slydif/cncBoard-for-fluidnc/README.md

KiCad PCB for fluidnc CNC router.
- Opto-coupled inputs with hysterese (schmitt triggers)
- 16 extra outputs with i2s driven shiftregisters.
- 2 relais can be used.
- 5 axes can be used.
- Buck-converter can be attached
- SD-card support.
- Tested and working.
