slydif/cncBoard-for-fluidnc/cncBord4sdo/projectData/6-Pack_CNC_Controller-main/images/6_pack_expansion.jpg

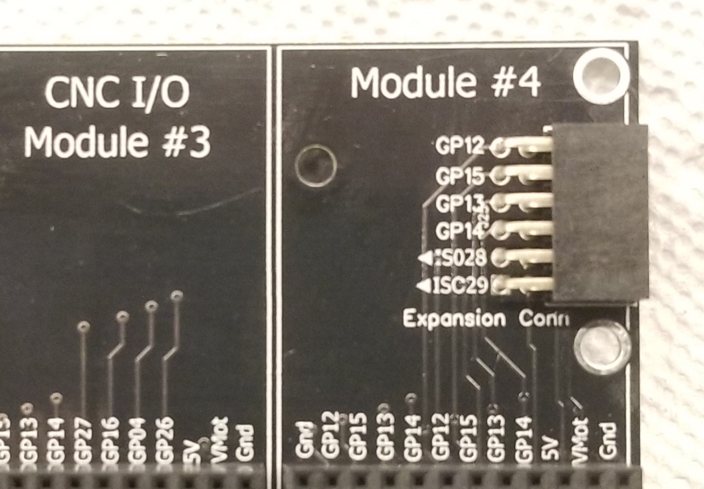
cncBord4sdo/projectData/6-Pack_CNC_Controller-main/images/6_pack_expansion.jpg
