slydif/cncBoard-for-fluidnc/cncBord4sdo/projectData/6-Pack_CNC_Controller-main/images/20200711_132253.jpg

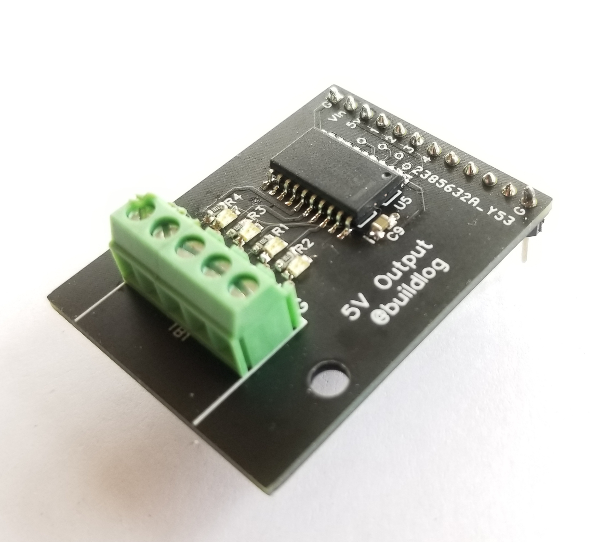
cncBord4sdo/projectData/6-Pack_CNC_Controller-main/images/20200711_132253.jpg
