slydif/cncBoard-for-fluidnc/cncBord4sdo/projectData/6-Pack_CNC_Controller-main/images/expansion_port_pinout.png

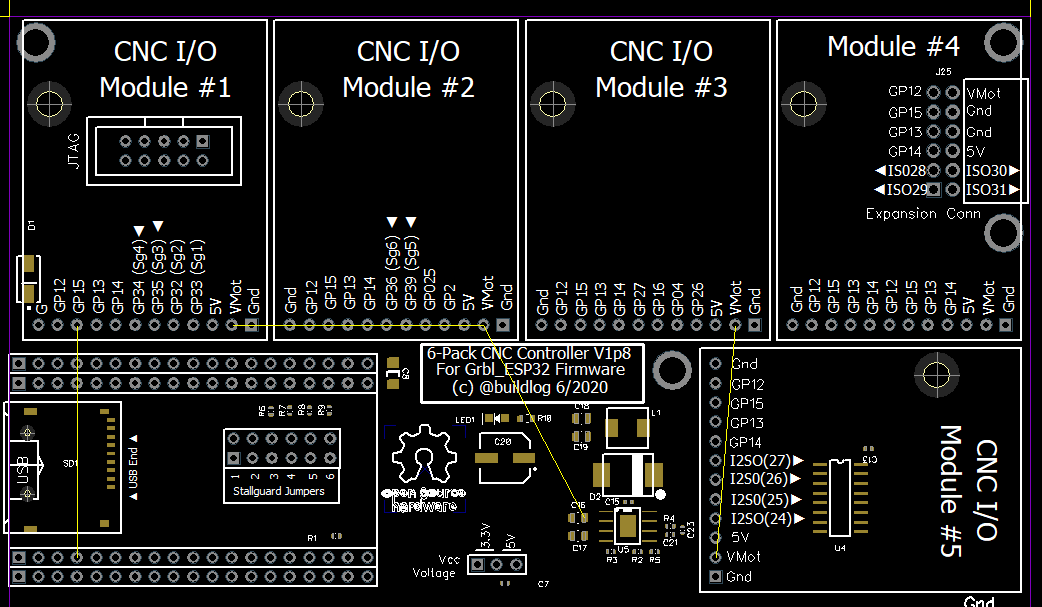
cncBord4sdo/projectData/6-Pack_CNC_Controller-main/images/expansion_port_pinout.png
