slydif/cncBoard-for-fluidnc/cncBord4sdo/projectData/6-Pack_CNC_Controller-main/images/iot_relay.png

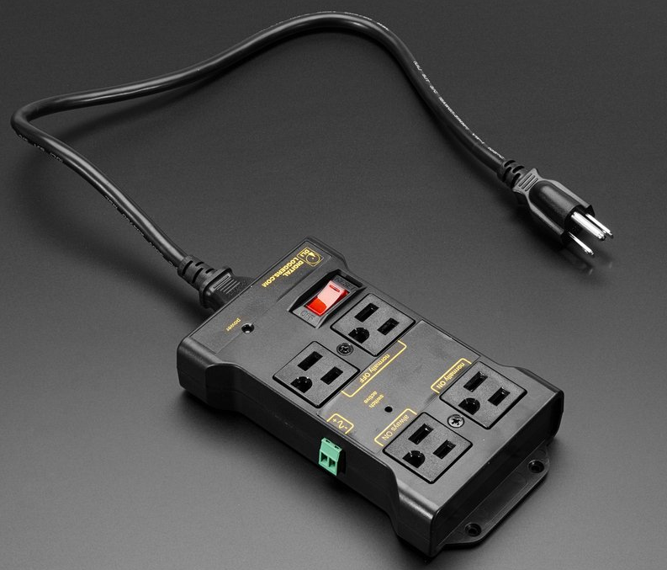
cncBord4sdo/projectData/6-Pack_CNC_Controller-main/images/iot_relay.png
