slydif/cncBoard-for-fluidnc/cncBord4sdo/projectData/6-Pack_CNC_Controller-main/images/switch_types.png

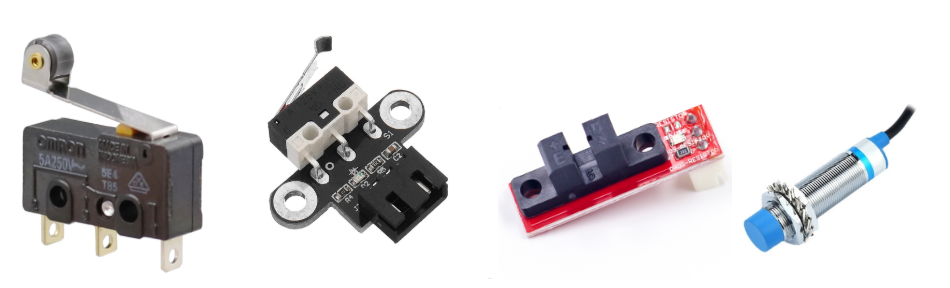
cncBord4sdo/projectData/6-Pack_CNC_Controller-main/images/switch_types.png
