slydif/cncBoard-for-fluidnc/cncBord4sdo/projectData/HTB1w9n5KVXXXXc5XVXX760XFXXXu.png

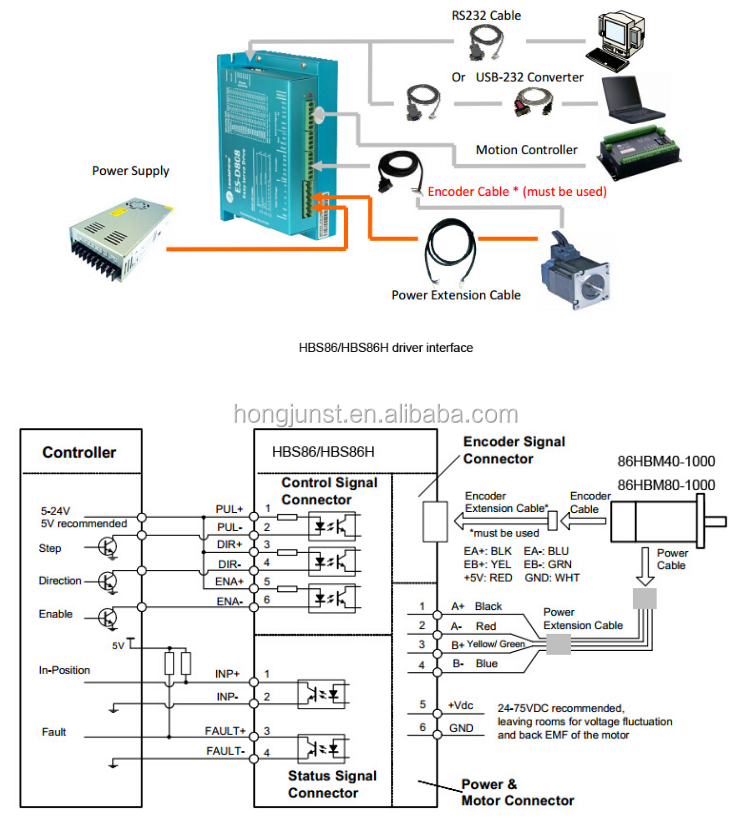
cncBord4sdo/projectData/HTB1w9n5KVXXXXc5XVXX760XFXXXu.png
