slydif/cncBoard-for-fluidnc/cncBord4sdo/projectData/sdcard board.jpg

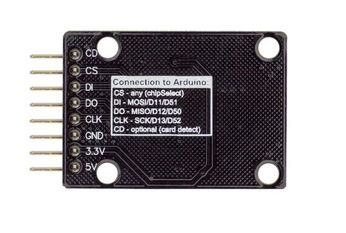
cncBord4sdo/projectData/sdcard board.jpg
