slydif/cncBoard-for-fluidnc/cncBord4sdo/projectData/sdCard pinout.jpg

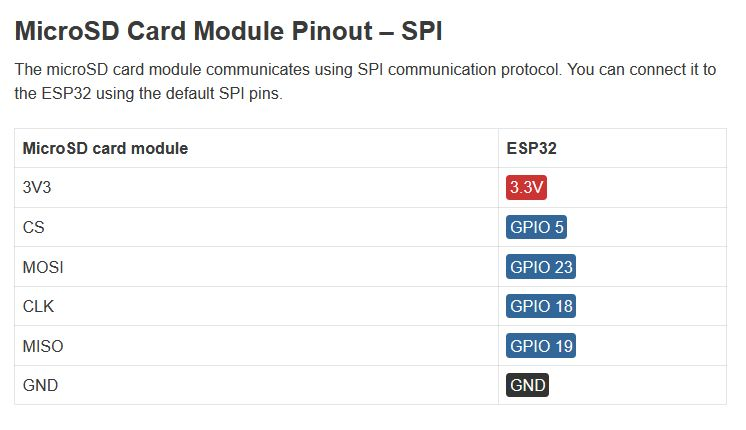
cncBord4sdo/projectData/sdCard pinout.jpg
