slydif/cncBoard-for-fluidnc/cncBord4sdo/projectData/6-Pack_CNC_Controller-main/versions/V1p1/gerbers/BOM 6_Pack_V1p1.xlsx

RefDes | Quantity | Qty SMT | Qty TH | Name | Value | Manufacturer | Mfg P/N | Source
C1, C2 | 2 | 2 |  | Capacitor 1206 | 10uF | Taiyo Yuden | GMK316BJ106KL-T | https://lcsc.com/product-detail/Multilayer-Ceramic-Capacitors-MLCC-SMD-SMT_Taiyo-Yuden-GMK316BJ106KL-T_C92797.html
C3, C6, C7, C13, C14, C23, C24, C25, C26, C27, C28 | 11 | 11 |  | Capacitor 0805 | 100nF | Kemet | C0805C104K5RACAUTO | https://lcsc.com/product-detail/Multilayer-Ceramic-Capacitors-MLCC-SMD-SMT_KEMET_C0805C104K5RACAUTO_100nF-104-10-50V-Car-level_C129641.html
C4 | 1 | 1 |  | Capacitor 0805 | 150pF | CCTC | TCC0805X7R151K500BT | https://lcsc.com/product-detail/Multilayer-Ceramic-Capacitors-MLCC-SMD-SMT_CCTC-TCC0805X7R151K500BT_C282743.html
C5, C9 | 2 | 2 |  | Capacitor 1206 | 22uF 6.3V | Taiyo Yuden | JMK316BJ226KL-T | https://lcsc.com/product-detail/Multilayer-Ceramic-Capacitors-MLCC-SMD-SMT_TAIYO-YUDEN_JMK316BJ226KL-T_22uF-226-10-6-3V_C92791.html
C8 | 1 | 1 |  | Capacitor, Electrolytic | 100u 16V | Panasonic | EEEHAC101WAP | https://lcsc.com/product-detail/Aluminum-Electrolytic-Capacitors-SMD_PANASONIC-EEEHAC101WAP_C336467.html
C17, C18, C19, C20, C21, C22 | 6 | 6 |  | Capacitor, Electrolytic | 330uF 50V | Lelon | VZT331M1HTR-1010 | https://lcsc.com/product-detail/Others_Lelon-VZT331M1H1010-TRO_C249985.html
D1, D2 | 2 | 2 |  | Diode, Schottkey 3A DO-214AC | 3A | (MDD) Jiangsu Yutai Elec | C64982 | https://lcsc.com/product-detail/Schottky-Barrier-Diodes-SBD_Jiangsu-Yutai-Elec-B340A_C64982.html
J1, J3, J6,J9 | 4 |  | 4 | 1x19 Female Header 0.1 |  | AliExpress |  | https://www.aliexpress.com/item/100Pcs-Per-Lot-2-54mm-Pitch-1x19-Pin-19-Pin-Female-Single-Row-Straight-Header-Strip/32760221364.html
J4, J5, J8, JP1, JP2, JP3, JP4 | 7 |  | 7 | Header, Male 1x3 0.1 | 1x3 | Boom Precision Elec | C49257 | https://lcsc.com/product-detail/Pin-Header-Female-Header_BOOMELE-Boom-Precision-Elec-C49257_C49257.html
J12 | 1 |  | 1 | Header, Male 2x6 | 2x6 | MINTRON | MTP125-1206S1 | https://lcsc.com/product-detail/Pin-Header-Female-Header_MINTRON-MTP125-1206S1_C358695.html
J14, J15, J16, J17, J18, J19, J26, J27, J28, J29, J30, J31 | 12 |  | 12 | Header, Female 1x8 | 1x8 | BOOMELE(Boom Precision Elec) | C27438 | https://lcsc.com/product-detail/Female-Header_2-54mm-1-8P-Straight-Female-header_C27438.html
J20, J21, J22, J23, J24, J25 | 6 |  | 6 | Header, Female 1x2 | 1x2 | BOOMELE(Boom Precision Elec) | C49661 | https://lcsc.com/product-detail/Pin-Header-Female-Header_BOOMELE-Boom-Precision-Elec-C49661_C49661.html
J33 | 0 |  |  | Do not place
L1 | 1 | 1 |  | Inductor | 4.7uH | Chilisin Elec | MHCI06030-4R7M-R8 | https://lcsc.com/product-detail/Power-Inductors_Chilisin-Elec-MHCI06030-4R7M-R8_C108295.html
LED1 | 1 | 1 |  | LED Clear Green 0805 |  | Foshan NationStar Optoelectronics | NCD0805G1 | https://lcsc.com/product-detail/Light-Emitting-Diodes-LED_Emerald-SMDLED-Iv-220-270mcd-atIF-5mA_C84260.html
MOD1, MOD2, MOD3, MOD4, MOD5 | 5 |  | 5 | Header, Feamle 1x12 | 1x12 | HOAUC | 2685Y-112CNG1SNA01 | https://lcsc.com/product-detail/Pin-Header-Female-Header_HOAUC-2685Y-112CNG1SNA01_C350303.html
R1, R2 | 2 | 2 |  | RES_0805 | 100k | YAGEO | AC0805FR-07100KL | https://lcsc.com/product-detail/Chip-Resistor-Surface-Mount_100KR-1003-1_C144587.html
R3 | 1 | 1 |  | RES_0805 | 40.2k | YAGEO | AC0805FR-0740K2L | https://lcsc.com/product-detail/Others_YAGEO-AC0805FR-0740K2L_C228820.html
R4 | 1 | 1 |  | RES_0805 | 210k | YAGEO | AC0805FR-07210KL | https://lcsc.com/product-detail/Others_YAGEO-AC0805FR-07210KL_C228629.html
R5, R6, R7, R8 | 4 | 4 |  | RES_0805 | 10k | YAGEO | AC0805FR-0710KL | https://lcsc.com/product-detail/Chip-Resistor-Surface-Mount_10KR-1002-1_C140868.html
R10 | 1 | 1 |  | RES_0805 | 300R | YAGEO | RC0805FR-07300RL | https://lcsc.com/product-detail/Chip-Resistor-Surface-Mount_300R-300R-1_C114529.html
SD1 | 1 | 1 |  | TF-01A |  | Korean Hroparts Elec TF-01A | TF-01A | https://lcsc.com/product-detail/Connector-Card-Sockets_Korean-Hroparts-Elec-TF-01A_C91145.html
TB1 | 1 |  | 1 | 2 Pos Terminal Block |  | Ningbo Xinlaiya Elec. | XY2500R-B-5.00-2P | https://lcsc.com/product-detail/Pluggable-System-Terminal-Block_Ningbo-Xinlaiya-Elec-XY2500R-B-5-00-2P_C505815.html
TB2, TB3, TB4, TB5, TB6, TB7 | 0 |  |  | 4 Pos Terminal Block |  | Phoenix Contact | 1945119 | https://www.mouser.com/ProductDetail/Phoenix-Contact/1945119?qs=BYlwlsDsB%2FoxVFDUDE1oIQ%3D%3D
U1 | 1 | 1 |  | Power Supply, Buck 3A | 3A | Monolithic Power Systems | MP1584EN-LF-Z | https://lcsc.com/product-detail/DC-DC-Converters_MPS_MP1584EN-LF-Z_MP1584EN-LF-Z_C15051.html
U2, U3, U4, U5 | 4 | 4 |  | 74AHCT595 | 74AHCT595 | Nexperia | 74AHCT595D,118 | https://www.mouser.com/ProductDetail/Nexperia/74AHCT595D118?qs=P62ublwmbi%2FjQEpjzH34Ig%3D%3D
Totals | 65 | 29 | 36
