slydif/cncBoard-for-fluidnc/cncBord4sdo/projectData/6-Pack_CNC_Controller-main/versions/V1p8/gerbers/6_Park_V1p8_BOM.xlsx

RefDes | Value | Name | Quantity | SMT | TH | Manufacturer | MFG P/N | Source
C1, C2, C3, C4, C5, C6, C7, C9, C11, C13, C15 | 100nF | NP_100nF_50V_0402 | 11 | 11 |  | Samsung Electro-Mechanics | CL05B104KB54PNC | https://lcsc.com/product-detail/Others_Samsung-Electro-Mechanics_CL05B104KB54PNC_Samsung-Electro-Mechanics-CL05B104KB54PNC_C307331.html
C8 | Do Not Place | NP_DNP_1206 |  |  |  | DNP | DN
C10, C12, C14, C22, C24, C25 | 330uF | POL_330uF_50V_10x10 | 6 | 6 |  | KS | UT1H331M1010VG | https://lcsc.com/product-detail/Aluminum-Electrolytic-Capacitors-SMD_KS-UT1H331M1010VG_C963258.html
C16, C17 | 2.2uF 50V | NP_2.2uF_50V_0805 | 2 | 2 |  | Guangdong Fenghua Advanced Tech | 0805F225M500NT | https://lcsc.com/product-detail/Multilayer-Ceramic-Capacitors-MLCC-SMD-SMT_FH-Guangdong-Fenghua-Advanced-Tech-0805F225M500NT_C49217.html
C18, C19 | 47uF 6.3V | NP_47uF_6.3V_0805 | 2 | 2 |  | Samsung Electro-Mechanics | CL21A476MQYNNNE | https://lcsc.com/product-detail/Multilayer-Ceramic-Capacitors-MLCC-SMD-SMT_SAMSUNG_CL21A476MQYNNNE_47uF-476-20-6-3V_C16780.html
C20 | 100uF 16V | POL_100uF_16V_6.3x5.4 | 1 | 1 |  | ROQANG | RT1C101M0605 | https://lcsc.com/product-detail/Aluminum-Electrolytic-Capacitors-SMD_ROQANG-RT1C101M0605_C267461.html
C21 | 39pF 50V | NP_39pF_50V_0402 | 1 | 1 |  | Yageo | CC0402JRNPO9BN390 | https://lcsc.com/product-detail/Multilayer-Ceramic-Capacitors-MLCC-SMD-SMT_39pF-390-5-50V_C106223.html/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
C23 | 6.8nF 50V | NP_6.8nF_50V_0402 | 1 | 1 |  | Guangdong Fenghua Advanced Tech | 0402B682K500NT | https://lcsc.com/product-detail/Multilayer-Ceramic-Capacitors-MLCC-SMD-SMT_6-8nF-682-10-50V_C1542.html
D1 | 40V 3A | Schottkey_40V_3A_DO-214AC | 1 | 1 |  | MDD（Microdiode Electronics） | B340A | https://lcsc.com/product-detail/Schottky-Barrier-Diodes-SBD_Jiangsu-Yutai-Elec-B340A_C64982.html
D2 | B560C | B560C | 1 | 1 |  | Diodes Incorporated | B560C-13-F | https://lcsc.com/product-detail/Schottky-Barrier-Diodes-SBD_Diodes-Incorporated-B560C-13-F_C85100.html
J1, J8, J12, J15, J19, J26 | 2 Pos | HDR Socket 1x2 0.1 | 6 |  | 6 | BOOMELE(Boom Precision Elec) | C49661 | https://lcsc.com/product-detail/Pin-Header-Female-Header_BOOMELE-Boom-Precision-Elec-C49661_C49661.html
J2, J3, J9, J10, J13, J14, J16, J17, J20, J21, J27, J28 | 8S | HDR Socket 1x8 0.1 | 12 |  | 12 | BOOMELE(Boom Precision Elec) | C27438 | https://lcsc.com/product-detail/Female-Header_2-54mm-1-8P-Straight-Female-header_C27438.html
J4, J5, J6, J7 | 19S | HDR Socket 1x19 0.1 | 4 |  | 4 | BOOMELE(Boom Precision Elec) | C319202 | https://lcsc.com/product-detail/Lack-of-specifications_BOOMELE-Boom-Precision-Elec-C319202_C319202.html
J11 | Do Not Place | DC3-10P
J18 | 6S | HDR Pin 2x6 0.1 | 1 |  | 1 | MINTRON | MTP125-1206S1 | https://lcsc.com/product-detail/Pin-Header-Female-Header_MINTRON-MTP125-1206S1_C358695.html
J22, J23, J24 | 3P | HDR Pin 1x3 0.1 | 3 |  | 3 | BOOMELE(Boom Precision Elec) | C49257 | https://lcsc.com/product-detail/Pin-Header-Female-Header_BOOMELE-Boom-Precision-Elec-C49257_C49257.html
J25 | Do Not Place | Header_2x6S_RA |  |  | 1
JP1, JP2, JP3, JP4 | 3P | Jumper_3p | 4 |  | 4 | BOOMELE(Boom Precision Elec) | C49257 | https://lcsc.com/product-detail/Pin-Header-Female-Header_BOOMELE-Boom-Precision-Elec-C49257_C49257.html
L1 | 10uH | 10uH_SMD_5.2x5.4 | 1 | 1 |  | Sunlord | MWSA0503S-100MT | https://lcsc.com/product-detail/Power-Inductors_Sunlord-MWSA0503S-100MT_C408412.html
LED1 | GRN | LED_GRN_0805 (Foshan) | 1 | 1 |  | Foshan NationStar Optoelectronics | NCD0805G1 | https://lcsc.com/product-detail/Light-Emitting-Diodes-LED_Foshan-NationStar-Optoelectronics-NCD0805G1_C84260.html
MH1, MH2, MH3, MH4, MH5, MH6 | Do Not Place | Mounting_hole_M3.7
MOD1, MOD2, MOD3, MOD4, MOD5 | 1x12 Socket | CNC_Module_Socket | 5 |  | 5 | CJT(Changjiang Connectors) | A2541HWV-12P | https://lcsc.com/product-detail/Pin-Header-Female-Header_CJT-Changjiang-Connectors-A2541HWV-12P_C225509.html
R1, R6, R7, R8, R9 | 10k | 10k_0402 | 5 | 5 |  | YAGEO | RC0402FR-0710KL | https://lcsc.com/product-detail/Chip-Resistor-Surface-Mount_YAGEO-RC0402FR-0710KL_C60490.html
R2 | 270k | 270k_0402 | 1 | 1 |  | Uniroyal Elec | 0402WGF2703TCE | https://lcsc.com/product-detail/Chip-Resistor-Surface-Mount_Uniroyal-Elec-0402WGF2703TCE_C25770.html/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
R3 | 100k | 100k_0402 | 1 | 1 |  | Uniroyal Elec | 0402WGF1003TCE | https://lcsc.com/product-detail/Chip-Resistor-Surface-Mount_Uniroyal-Elec-0402WGF1003TCE_C25741.html/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
R4 | 13k | 13k_0402 | 1 | 1 |  | Uniroyal Elec | 0402WGF1302TCE | https://lcsc.com/product-detail/Chip-Resistor-Surface-Mount_UNI-ROYAL-Uniroyal-Elec-0402WGF1302TCE_C25754.html
R5 | 51k | 51k_0402 | 1 | 1 |  | Uniroyal Elec | 0402WGF5102TCE | https://lcsc.com/product-detail/Chip-Resistor-Surface-Mount_Uniroyal-Elec-0402WGF5102TCE_C25794.html/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
R10 | 3.0k | 3.0k_0603 | 1 | 1 |  | YAGEO | RC0603FR-073KL | https://lcsc.com/product-detail/Chip-Resistor-Surface-Mount_3KR-3001-1_C126358.html
SD1 | Micro SD | TF-01A | 1 | 1 |  | Korean Hroparts Elec | TF-01A | https://lcsc.com/product-detail/Card-Sockets-Connectors_Korean-Hroparts-Elec-TF-01A_C91145.html
TB1, TB2, TB3, TB5, TB6, TB7 | 4 Pos | TB_3p5mm_4POS_KF2EDGR | 6 |  | 6 | Cixi Kefa Elec | KF2EDGR-3.5-4P | https://lcsc.com/product-detail/Pluggable-System-Terminal-Block_Cixi-Kefa-Elec-KF2EDGR-3-5-4P_C441173.html
TB4 | 2 Pos | TB_5mm_2POS Socket | 1 |  | 1 | Ningbo Xinlaiya Elec. | XY2500R-B-5.00-2P | https://lcsc.com/product-detail/Pluggable-System-Terminal-Block_Ningbo-Xinlaiya-Elec-XY2500R-B-5-00-2P_C505815.html
U1, U2, U3, U4 | 74AHCT595 | 74AHCT595 | 4 | 4 |  | Texas Instruments | SN74AHCT595DR | https://lcsc.com/product-detail/74-Series_Texas-Instruments_SN74AHCT595DR_Texas-Instruments-Texas-Instruments-SN74AHCT595DR_C133793.html
U5 | TPS54360 | TPS54360DDAR | 1 | 1 |  | Texas Instruments | TPS54360DDAR | https://lcsc.com/product-detail/DC-DC-Converters_Texas-Instruments-Texas-Instruments-TPS54360DDAR_C44377.html
 |  | Total parts | 86 | 44 | 43
 |  | Unique count | 29 | 20 | 10
