slydif/cncBoard-for-fluidnc/cncBord4sdo/projectData/6-Pack_CNC_Controller-main/CNC_IO_Modules/0_10V_Spindle/V1p1/Gerbers/BOM CNC Module 0_10V.xlsx

RefDes | Quantity | Qty SMT | Qty TH | Value | Name | Pattern | Manufacturer | MFG P/N | Source | Alt Source
C1, C2 | 1 | 1 |  | 100nF | CAP_0805 | CAP_0805 | Kemet | C0805C104K5RACAUTO | https://lcsc.com/product-detail/Multilayer-Ceramic-Capacitors-MLCC-SMD-SMT_KEMET_C0805C104K5RACAUTO_100nF-104-10-50V-Car-level_C129641.html
LED1, LED2, LED3, LED4 | 4 | 4 |  | Green | LED Green Clear | 805 | Lite-On | LTST-C170KGKT | https://lcsc.com/product-detail/Light-Emitting-Diodes-LED_Lite-On-LTST-C170KGKT_C98221.html
MOD1 | 1 |  | 0 | Do not place
OPT1, OPT2 | 2 | 2 |  | Opto | Opto | SMD4 | Everlight Elec | EL817S1(D)(TU)-F | https://lcsc.com/product-detail/Optocouplers_Everlight-Elec-EL817S1-D-TU-F_C108319.html
R1, R2, R3, R4, R5 | 5 | 5 |  | 300R | Resistor 300R 1% |  | YAGEO | AC0805FR-07300RL | https://lcsc.com/product-detail/_AC0805FR-07300RL_C144566.html
R6, R9, R10 | 4 | 4 |  | 10k | Resistor 10k 1% | RES_0805 | YAGEO | AC0805FR-0710KL | https://lcsc.com/product-detail/Chip-Resistor-Surface-Mount_10KR-1002-1_C140868.html
R7 | 1 | 1 |  | 20k | Pot 20K SMT | Pot | HDK(Hokuriku Elec Industry) | VG039NCHXTB203 | https://lcsc.com/product-detail/Variable-Resistors_HDK-Hokuriku-Elec-Industry-VG039NCHXTB203_C128550.html
R8 | 1 | 1 |  | 4.99K | Resistor 4.99K 1% 0805 | 805 | YAGEO | AC0805FR-074K99L | https://lcsc.com/product-detail/Others_YAGEO-AC0805FR-074K99L_C228871.html
TB1 | 1 |  | 0 | Do Not Place
U1 | 1 | 1 |  | LM358P | LM358 | SOIC-8 | STMicroelectronics | LM358ADT | https://lcsc.com/product-detail/General-Purpose-Amplifiers_STMicroelectronics-LM358ADT_C92457.html
Total |  | 19
