slydif/cncBoard-for-fluidnc/cncBord4sdo/projectData/6-Pack_CNC_Controller-main/CNC_IO_Modules/4x_Opto_Input/V1p1/fab/BOM_Input_Module_V1p1.xlsx

RefDes | Quantity | Qty SMT | Qty TH | Value | Name | Pattern | Manufacturer | Mfg P/N | Source
C1, C2 | 2 | 2 |  | 1uF | Capacitor 0805 1uF 50V 20% | CAP_0805 | CCTC | TCC0805X7R105K500DTB | https://lcsc.com/product-detail/Multilayer-Ceramic-Capacitors-MLCC-SMD-SMT_CCTC-TCC0805X7R105K500DTB_C282736.html
C3 | 1 | 1 |  | 2.2uF | Capacitor 0805 | CAP_0805 | Samsung Electro-Mechanics | CL21B225KOFNNNE | https://lcsc.com/product-detail/Multilayer-Ceramic-Capacitors-MLCC-SMD-SMT_SAMSUNG_CL21B225KOFNNNE_2-2uF-225-10-16V_C28234.html
C4, C5, C6, C7, C8 | 4 | 4 |  | 100nF | Capacitor 0603 | CAP_0603 | Walsin Tech Corp | 0603F104Z250 | https://lcsc.com/product-detail/Multilayer-Ceramic-Capacitors-MLCC-SMD-SMT_Walsin-Tech-Corp-0603F104Z250_C125841.html
MOD1 | 0 |  |  |  | Header, Male 1x12 0.1" | Do Not Place
OPT1 | 1 | 1 |  | TP521-4 | Optocoupler | TLP521-4SM | Isocom Components | TLP521-4GBSM | https://lcsc.com/product-detail/Optocouplers_Isocom-Components-TLP521-4GBSM_C191332.html
PS1 | 1 |  | 0 | 5V | Isloated P/S 5V/5V | Do Not Place
PS2 | 1 | 1 |  |  | LDO 5V | SOT89 | Diodes Incorporated | AP2204RA-3.3TRG1 | https://lcsc.com/product-detail/Low-Dropout-Regulators-LDO_Diodes-Incorporated-AP2204RA-3-3TRG1_C151625.html
R1, R2, R3, R4 | 4 | 4 |  | 300 | Resitor 0603 | RES_0603 | LIZ Elec | CR0603JA0301G | https://lcsc.com/product-detail/Chip-Resistor-Surface-Mount_LIZ-Elec-CR0603JA0301G_C101323.html
R5, R6, R7, R8 | 4 | 4 |  | 10k | Resitor 0603 | RES_0603 | YAGEO | RC0603FR-0710KL | https://lcsc.com/product-detail/Chip-Resistor-Surface-Mount_10KR-1002-1_C98220.html
R9, R10, R11, R12, R13 | 5 | 5 |  | 220 | Resitor 0603 | RES_0805 | YAGEO | RC0603FR-07220RL | https://lcsc.com/product-detail/Chip-Resistor-Surface-Mount_220R-220R-1_C107696.html
TB1, TB3 | 0 |  | 0 |  | Do not place | Do not place
TB2, TB4 | 0 |  | 0 |  | Do not place | Do not place
U2 | 1 | 1 |  |  | Schmitt Trigger SN74AC14D | TSSOP-14 | Texas Instruments | SN74HC14PWR | https://lcsc.com/product-detail/Gates-and-Inverters_Texas-Instruments_SN74HC14PWR_Texas-Instruments-Texas-Instruments-SN74HC14PWR_C6821.html
 |  | 23
