slydif/cncBoard-for-fluidnc/cncBord4sdo/projectData/6-Pack_CNC_Controller-main/CNC_IO_Modules/RS485/V1p0/fab/BOM CNC Module RS485 V1p1.xlsx

RefDes | Quantity | Qty SMT | Qty TH | Value | Name | Pattern | Manufacturer | MFG P/N | Source
C1 | 1 | 1 |  | 10uF | CAP_NP_1206 | CAP_1206 | Taiyo Yuden | GMK316BJ106KL-T | https://lcsc.com/product-detail/Multilayer-Ceramic-Capacitors-MLCC-SMD-SMT_Taiyo-Yuden-GMK316BJ106KL-T_C92797.html
C2 | 1 | 1 |  | 22uF |  | CAP_1206 | Taiyo Yuden | JMK316BJ226KL-T | https://lcsc.com/product-detail/Multilayer-Ceramic-Capacitors-MLCC-SMD-SMT_TAIYO-YUDEN_JMK316BJ226KL-T_22uF-226-10-6-3V_C92791.html
C3 | 1 | 1 |  | 100nF | CAP_0805 | CAP_0805 | Kemet | C0805C104K5RACAUTO | https://lcsc.com/product-detail/Multilayer-Ceramic-Capacitors-MLCC-SMD-SMT_KEMET_C0805C104K5RACAUTO_100nF-104-10-50V-Car-level_C129641.html
MOD1 | 1 |  | 0 |  | Do not place
R1, R2, R3 | 3 | 3 |  | 10k | RES_0805 | RES_0805 | YAGEO | AC0805FR-0710KL | https://lcsc.com/product-detail/Chip-Resistor-Surface-Mount_10KR-1002-1_C140868.html
R4, R6 | 2 | 2 |  | 20k | RES_0805 | RES_0805 | YAGEO | RC0805FR-0720KL | https://lcsc.com/product-detail/Chip-Resistor-Surface-Mount_20KR-2002-1_C114566.html
R5 | 1 | 1 |  | 120 | RES_0805 | RES_0805 | YAGEO | RC0805FR-07120RL | https://lcsc.com/product-detail/Chip-Resistor-Surface-Mount_120R-120R-1_C114245.html
TB1 | 1 |  | 0 |  | Do Not Place
U1 | 1 | 1 |  | 3.3V | AMS1117 | SOT223-4 | Advanced Monolithic Systems | AMS1117-3.3 | https://lcsc.com/product-detail/Low-Dropout-Regulators-LDO_AMS_AMS1117-3-3_AMS1117-3-3_C6186.html
U2 | 1 | 1 |  |  | MAX485CSA | SOIC-8/150mil | Maxim Integrated | MAX3485ESA+T | https://lcsc.com/product-detail/RS-485-RS-422-ICs_Maxim-Integrated_MAX3485ESA-T_Maxim-Integrated-MAX3485ESA-T_C18148.html
Total |  | 11
