slydif/cncBoard-for-fluidnc/cncBord4sdo/projectData/6-Pack_CNC_Controller-main/3D_Files/4x_support.stp

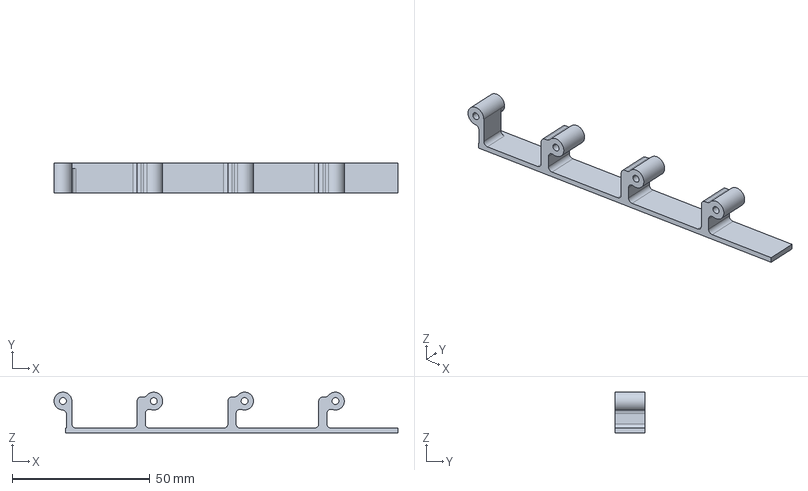
[picture p17: CAD file, 2023-04-05]
cncBord4sdo/projectData/6-Pack_CNC_Controller-main/3D_Files/4x_support.stp
125.1 x 11.0 x 14.8 mm
