slydif/cncBoard-for-fluidnc/cncBord4sdo/projectData/6-Pack_CNC_Controller-main/3D_Files/case/6_pack_case_bottom.stp

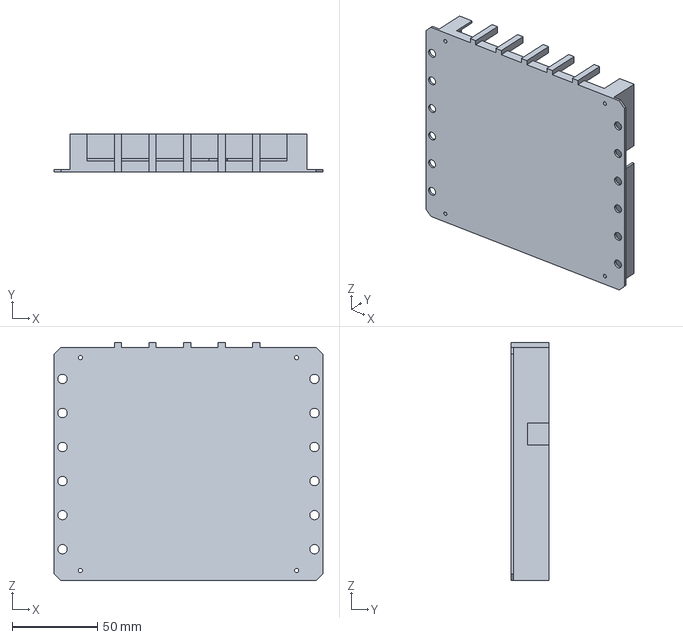
[picture p18: CAD file, 2023-04-05]
cncBord4sdo/projectData/6-Pack_CNC_Controller-main/3D_Files/case/6_pack_case_bottom.stp
158.0 x 22.2 x 140.0 mm
