slydif/cncBoard-for-fluidnc/cncBord4sdo/projectData/6-Pack_CNC_Controller-main/3D_Files/1x_supp.stp

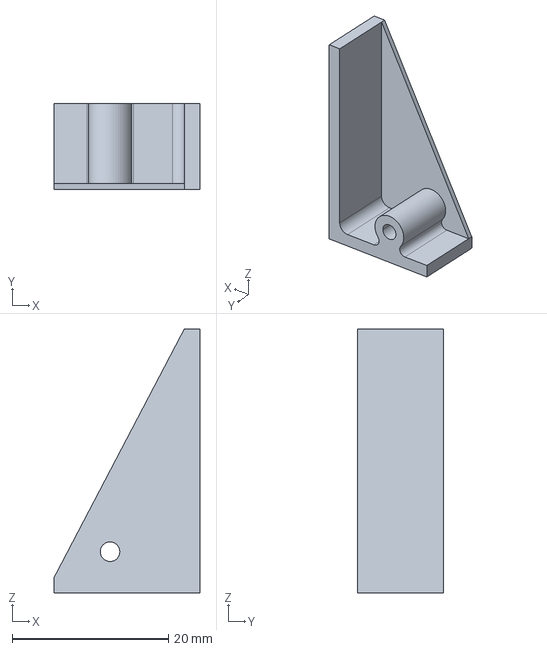
[picture p19: CAD file, 2023-04-05]
cncBord4sdo/projectData/6-Pack_CNC_Controller-main/3D_Files/1x_supp.stp
18.7 x 11.0 x 33.8 mm
