slydif/cncBoard-for-fluidnc/cncBord4sdo/projectData/6-Pack_CNC_Controller-main/3D_Files/case/6_pack_cover_top.stp

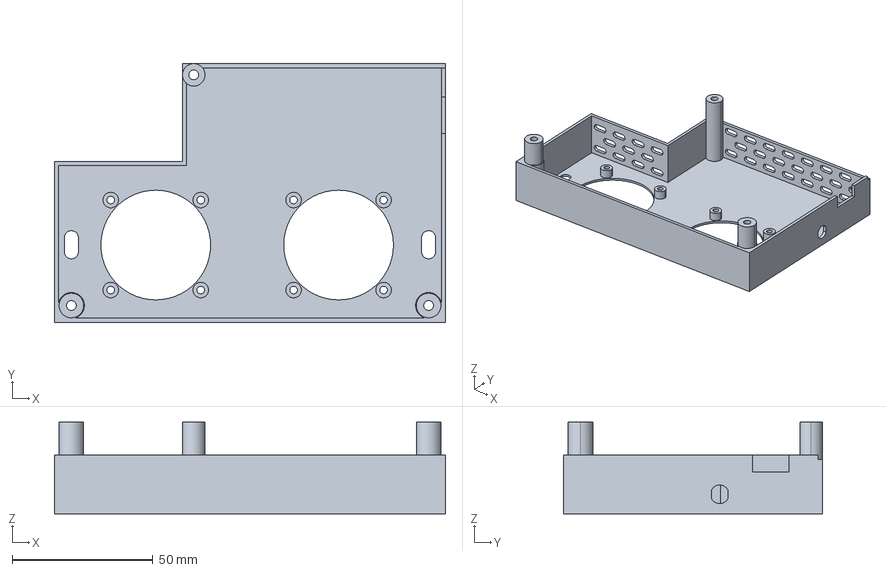
[picture p20: CAD file, 2023-04-05]
cncBord4sdo/projectData/6-Pack_CNC_Controller-main/3D_Files/case/6_pack_cover_top.stp
139.0 x 92.0 x 32.7 mm
