slydif/cncBoard-for-fluidnc/cncBord4sdo/projectData/6-Pack_CNC_Controller-main/3D_Files/case/dummy_module.stl

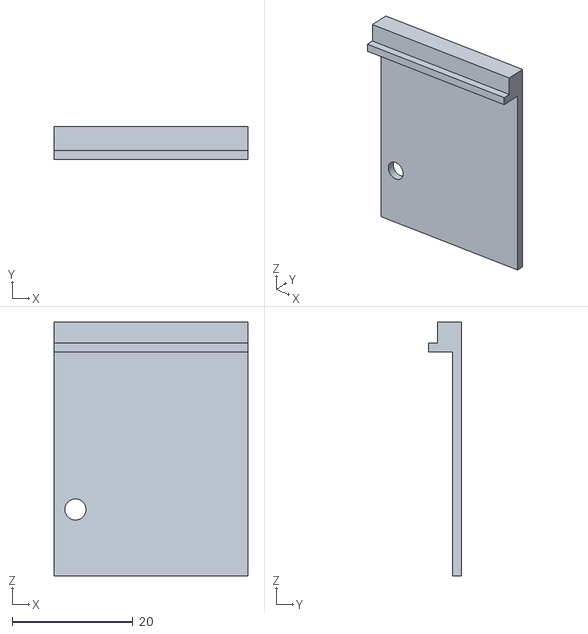
[picture p21: CAD file, 2023-04-05]
cncBord4sdo/projectData/6-Pack_CNC_Controller-main/3D_Files/case/dummy_module.stl
32.0 x 5.50 x 42.0
