slydif/cncBoard-for-fluidnc/(list of files, cad)

Other CAD files:
cncBord4sdo/projectData/6-Pack_CNC_Controller-main/3D_Files/1x_supp.stl
cncBord4sdo/projectData/6-Pack_CNC_Controller-main/3D_Files/4x_support.stl
cncBord4sdo/projectData/6-Pack_CNC_Controller-main/3D_Files/case/6_pack_case_bottom.stl
cncBord4sdo/projectData/6-Pack_CNC_Controller-main/3D_Files/case/6_pack_cover_top.stl
