slydif/cncBoard-for-fluidnc/cncBord4sdo/projectData/hbs86H wiring.jpg

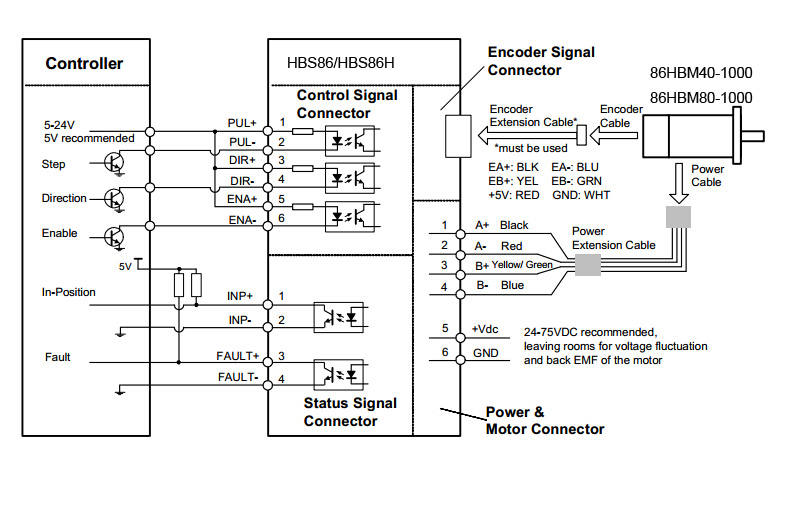
cncBord4sdo/projectData/hbs86H wiring.jpg
