slydif/cncBoard-for-fluidnc/cncBord4sdo/projectData/hbs860h wiring.jpg

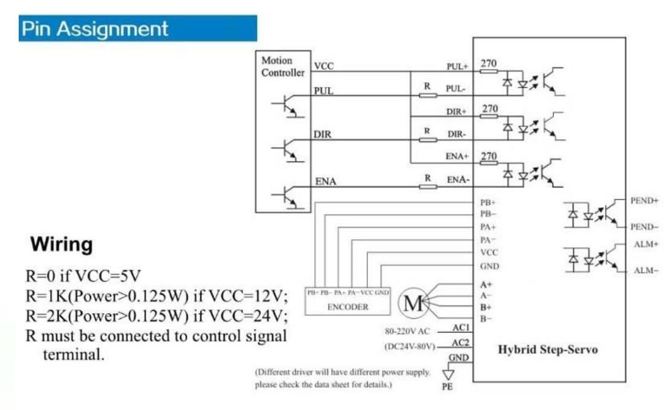
cncBord4sdo/projectData/hbs860h wiring.jpg
