slydif/cncBoard-for-fluidnc/cncBord4sdo/projectData/todo for next version.txt

- limit switches and buttons need 330ohm resistor at 3.3v line, to prevent crash when shortcut
- extra condensator
