slydif/cncBoard-for-fluidnc/(list of files, drawings)

Other design files:
cncBord4sdo/cncBord4sdo.dsn
cncBord4sdo/projectData/6-Pack_CNC_Controller-main/CNC_IO_Modules/4x_5V_Buffer_Output/V1p1/source_diptrace/CNC_module_4x_5V_output_V1p1.dch
cncBord4sdo/projectData/6-Pack_CNC_Controller-main/CNC_IO_Modules/4x_5V_Buffer_Output/V1p1/source_diptrace/CNC_module_4x_5V_output_V1p1.dip
cncBord4sdo/projectData/6-Pack_CNC_Controller-main/CNC_IO_Modules/4x_Opto_Input/V1p1/source_diptrace/CNC_Module_Opto_Schmitt_V1p1.dch
cncBord4sdo/projectData/6-Pack_CNC_Controller-main/CNC_IO_Modules/4x_Opto_Input/V1p1/source_diptrace/CNC_Module_Opto_Schmitt_V1p1.dip
cncBord4sdo/projectData/6-Pack_CNC_Controller-main/CNC_IO_Modules/4x_Opto_Input/V1p2/source/CNC_Module_Opto_Schmitt_V1p2.dch
cncBord4sdo/projectData/6-Pack_CNC_Controller-main/CNC_IO_Modules/4x_Opto_Input/V1p2/source/CNC_Module_Opto_Schmitt_V1p2.dip
cncBord4sdo/projectData/6-Pack_CNC_Controller-main/CNC_IO_Modules/External_Driver_Adapter/V0p5/Source/external_bridge.dch
cncBord4sdo/projectData/6-Pack_CNC_Controller-main/CNC_IO_Modules/External_Driver_Adapter/V0p5/Source/stepstick_external.dip
cncBord4sdo/projectData/6-Pack_CNC_Controller-main/CNC_IO_Modules/Protoboard/v1p0/source/proto_module.dch
cncBord4sdo/projectData/6-Pack_CNC_Controller-main/CNC_IO_Modules/Protoboard/v1p0/source/proto_module.dip
cncBord4sdo/projectData/6-Pack_CNC_Controller-main/CNC_IO_Modules/Quad_Input/V1p1/Quad_Basic_Input.dch
cncBord4sdo/projectData/6-Pack_CNC_Controller-main/CNC_IO_Modules/Quad_Input/V1p1/Quad_Basic_Input_V1p0.dip
cncBord4sdo/projectData/6-Pack_CNC_Controller-main/CNC_IO_Modules/Quad_MOSFET/source/Quad_MOSFET_V1p0.dch
cncBord4sdo/projectData/6-Pack_CNC_Controller-main/CNC_IO_Modules/Quad_MOSFET/source/Quad_MOSFET_V1p0.dip
cncBord4sdo/projectData/6-Pack_CNC_Controller-main/CNC_IO_Modules/RC_Servo/V1P0/CNC_module_RC_Servo.dch
cncBord4sdo/projectData/6-Pack_CNC_Controller-main/CNC_IO_Modules/RC_Servo/V1P0/CNC_module_RC_Servo.dip
cncBord4sdo/projectData/6-Pack_CNC_Controller-main/CNC_IO_Modules/Relay/V1p0/source_diptrace/CNC_Module_Relay_V1p0.dch
cncBord4sdo/projectData/6-Pack_CNC_Controller-main/CNC_IO_Modules/Relay/V1p0/source_diptrace/CNC_Module_Relay_V1p0.dip
cncBord4sdo/projectData/6-Pack_CNC_Controller-main/CNC_IO_Modules/Relay/V2p0/source/CNC_Module_Relay_V2p0.dch
cncBord4sdo/projectData/6-Pack_CNC_Controller-main/CNC_IO_Modules/Relay/V2p0/source/CNC_Module_Relay_V2p0.dip
cncBord4sdo/projectData/6-Pack_CNC_Controller-main/CNC_IO_Modules/RS485/V1p0/source_diptrace/CNC_Module_RS485_V1p0.dch
cncBord4sdo/projectData/6-Pack_CNC_Controller-main/CNC_IO_Modules/RS485/V1p0/source_diptrace/CNC_Module_RS485_V1p0.dip
cncBord4sdo/projectData/6-Pack_CNC_Controller-main/External_Driver_Adapter/V0p5/external_bridge.dch
cncBord4sdo/projectData/6-Pack_CNC_Controller-main/External_Driver_Adapter/V0p5/stepstick_external.dip
cncBord4sdo/projectData/6-Pack_CNC_Controller-main/versions/V0p5/source/6_Axis_I2C.dch
cncBord4sdo/projectData/6-Pack_CNC_Controller-main/versions/V0p5/source/6_axis_I2S.dip
cncBord4sdo/projectData/6-Pack_CNC_Controller-main/versions/V1p0/6_Axis_I2S_v1p0.dch
cncBord4sdo/projectData/6-Pack_CNC_Controller-main/versions/V1p1/source/6_Axis_I2S_v1p1.dch
cncBord4sdo/projectData/6-Pack_CNC_Controller-main/versions/V1p5/source/6_Axis_I2S_v1p5.dch
cncBord4sdo/projectData/6-Pack_CNC_Controller-main/versions/V1p8/source/6_Axis_I2S_v1p8.dch
