slydif/cncBoard-for-fluidnc/cncBord4sdo/cncBord4sdo.kicad_pcb

## KiCad design cncBord4sdo/cncBord4sdo.kicad_pcb (2023-04-05)

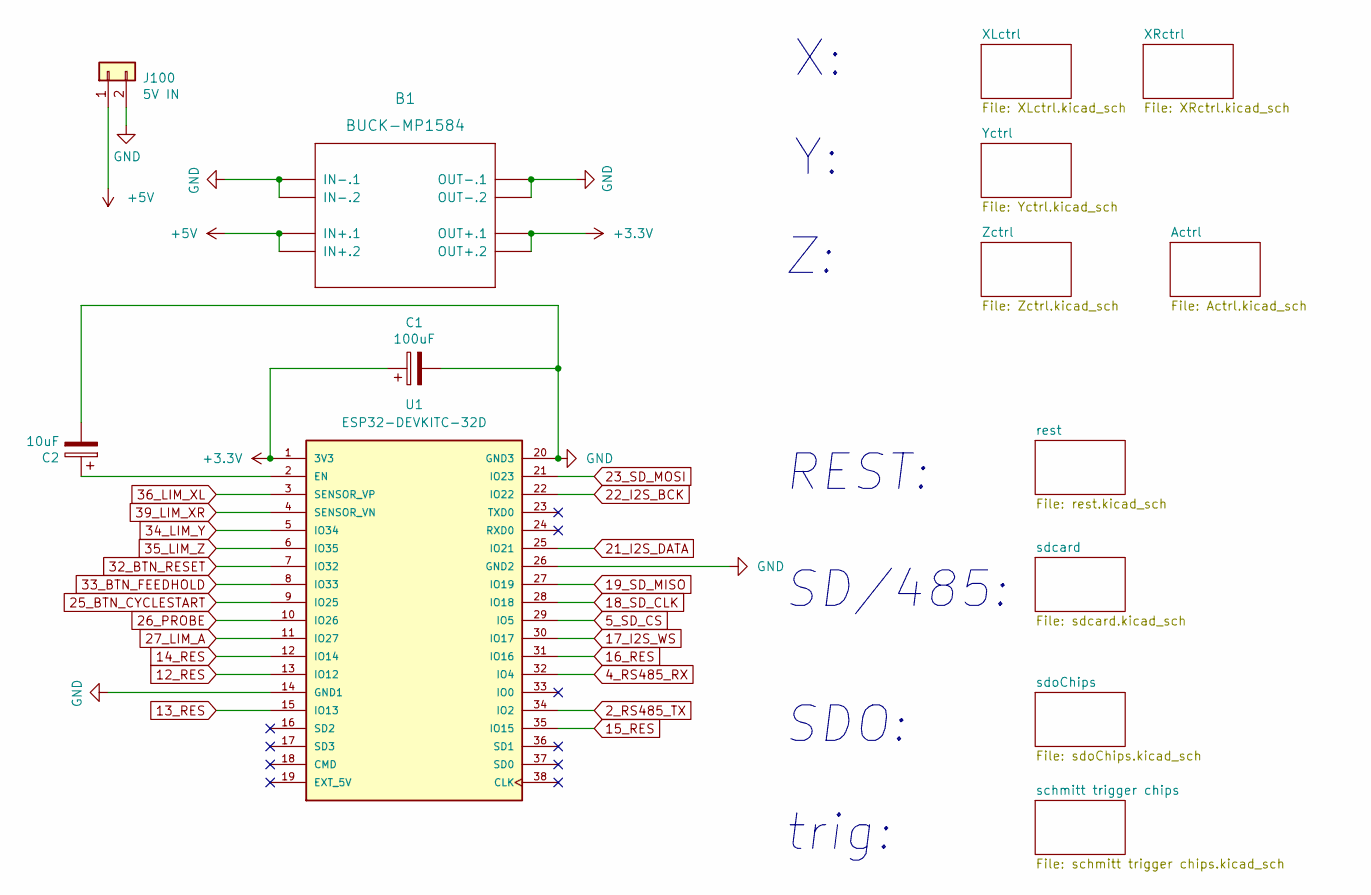
[picture p24: schematic cncBord4sdo.kicad_sch]

Parts:
B1: BUCK-MP1584; DC-DC-STEP-DOWN-MP1584
C1: 100uF; CP_Radial_D6.3mm_P2.50mm
C2: 10uF; CP_Radial_D6.3mm_P2.50mm
J100: 5V IN; PhoenixContact_MCV_1,5_2-G-5.08_1x02_P5.08mm_Vertical
U1: ESP32-DEVKITC-32D; MODULE_ESP32-DEVKITC-32D; PARTREV 4

Connections:
2_RS485_TX: U1.34 (IO2); also elsewhere on the board
4_RS485_RX: U1.32 (IO4); also elsewhere on the board
5_SD_CS: U1.29 (IO5); also elsewhere on the board
12_RES: U1.13 (IO12); also elsewhere on the board
13_RES: U1.15 (IO13); also elsewhere on the board
14_RES: U1.12 (IO14); also elsewhere on the board
15_RES: U1.35 (IO15); also elsewhere on the board
16_RES: U1.31 (IO16); also elsewhere on the board
17_I2S_WS: U1.30 (IO17); also elsewhere on the board
18_SD_CLK: U1.28 (IO18); also elsewhere on the board
19_SD_MISO: U1.27 (IO19); also elsewhere on the board
21_I2S_DATA: U1.25 (IO21); also elsewhere on the board
22_I2S_BCK: U1.22 (IO22); also elsewhere on the board
23_SD_MOSI: U1.21 (IO23); also elsewhere on the board
25_BTN_CYCLESTART: U1.9 (IO25); also elsewhere on the board
26_PROBE: U1.10 (IO26); also elsewhere on the board
27_LIM_A: U1.11 (IO27); also elsewhere on the board
32_BTN_RESET: U1.7 (IO32); also elsewhere on the board
33_BTN_FEEDHOLD: U1.8 (IO33); also elsewhere on the board
34_LIM_Y: U1.5 (IO34); also elsewhere on the board
35_LIM_Z: U1.6 (IO35); also elsewhere on the board
36_LIM_XL: U1.3 (SENSOR_VP); also elsewhere on the board
39_LIM_XR: U1.4 (SENSOR_VN); also elsewhere on the board
+3.3V: B1.OUT+.1, B1.OUT+.2, C1.1, U1.1 (3V3); also elsewhere on the board
+5V: B1.IN+.1, B1.IN+.2, J100.1; also elsewhere on the board
GND: B1.IN-.1, B1.IN-.2, B1.OUT-.1, B1.OUT-.2, C1.2, C2.2, J100.2, U1.14 (GND1), U1.20 (GND3), U1.26 (GND2); also elsewhere on the board
unnamed: C2.1, U1.2 (EN)

Notes on the sheet:
SDO:
trig:
SD/485:
REST:

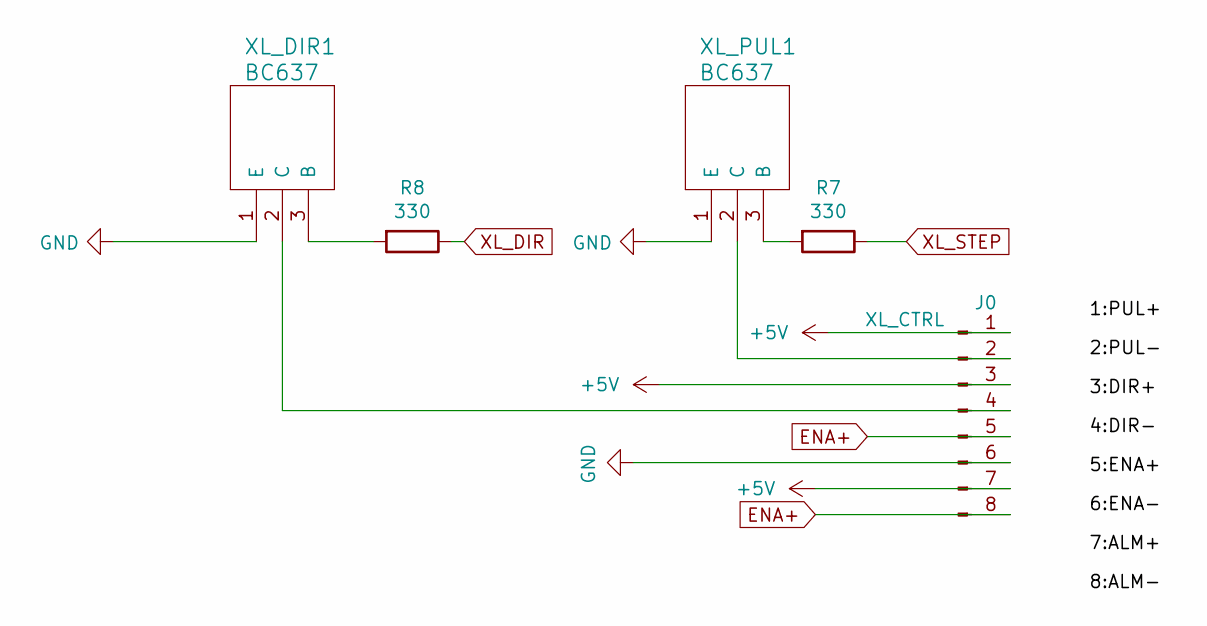
[picture p25: schematic XLctrl.kicad_sch]

Parts:
J0: XL_CTRL; JST_EH_B8B-EH-A_1x08_P2.50mm_Vertical
R7, R8: 330; R_1210_3225Metric_Pad1.30x2.65mm_HandSolder
XL_DIR1: BC637; TO-92_HandSolder
XL_PUL1: BC637; TO-92_HandSolder

Connections:
+5V: J0.1, J0.3, J0.7; also elsewhere on the board
ENA+: J0.5, J0.8; also elsewhere on the board
GND: J0.6, XL_DIR1.1 (E), XL_PUL1.1 (E); also elsewhere on the board
unnamed: J0.4, XL_DIR1.2 (C)
unnamed: R7.2, XL_PUL1.3 (B)
unnamed: R8.2, XL_DIR1.3 (B)
unnamed: J0.2, XL_PUL1.2 (C)
XL_DIR: R8.1; also elsewhere on the board
XL_STEP: R7.1; also elsewhere on the board

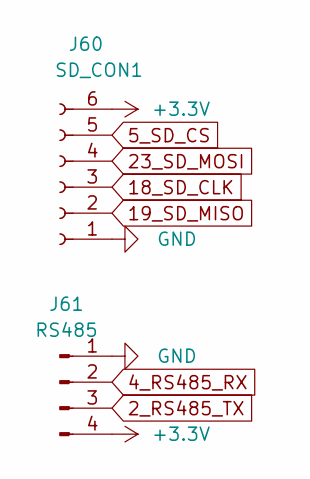
[picture p26: schematic sdcard.kicad_sch]

Parts:
J60: SD_CON1; PinHeader_1x06_P2.54mm_Vertical
J61: RS485; PinHeader_1x04_P2.54mm_Vertical

Connections:
2_RS485_TX: J61.3; also elsewhere on the board
4_RS485_RX: J61.2; also elsewhere on the board
5_SD_CS: J60.5; also elsewhere on the board
18_SD_CLK: J60.3; also elsewhere on the board
19_SD_MISO: J60.2; also elsewhere on the board
23_SD_MOSI: J60.4; also elsewhere on the board
+3.3V: J60.6, J61.4; also elsewhere on the board
GND: J60.1, J61.1; also elsewhere on the board

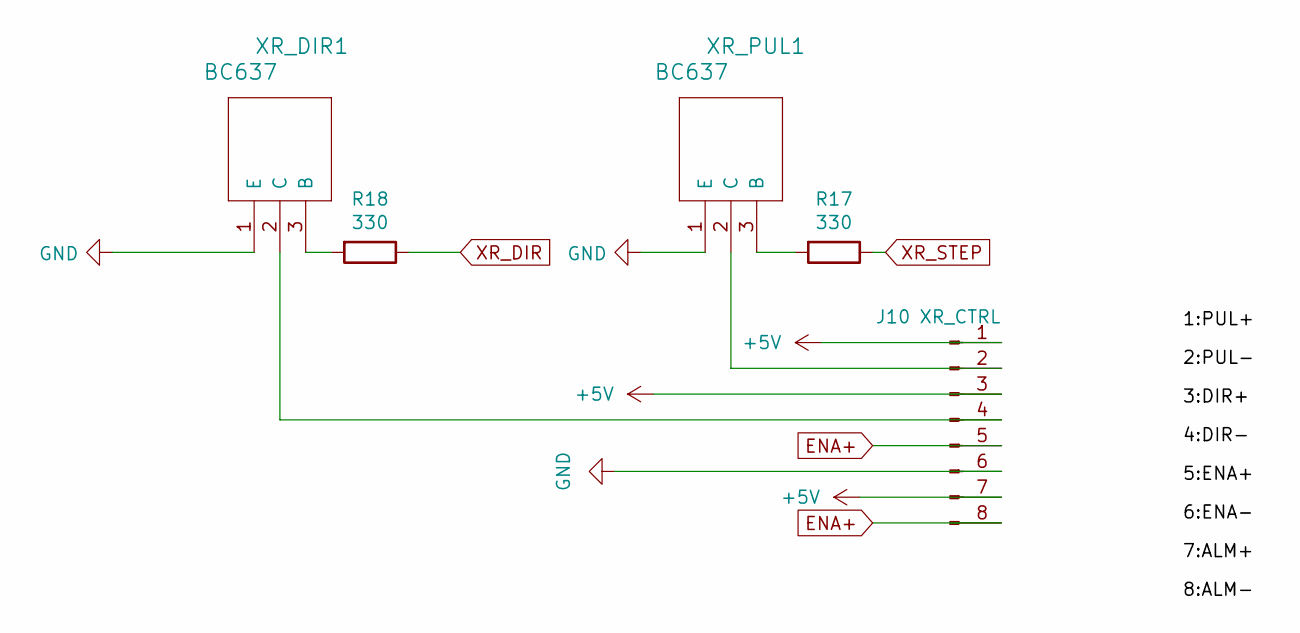
[picture p27: schematic XRctrl.kicad_sch]

Parts:
J10: XR_CTRL; JST_EH_B8B-EH-A_1x08_P2.50mm_Vertical
R17, R18: 330; R_1210_3225Metric_Pad1.30x2.65mm_HandSolder
XR_DIR1: BC637; TO-92_HandSolder
XR_PUL1: BC637; TO-92_HandSolder

Connections:
+5V: J10.1, J10.3, J10.7; also elsewhere on the board
ENA+: J10.5, J10.8; also elsewhere on the board
GND: J10.6, XR_DIR1.1 (E), XR_PUL1.1 (E); also elsewhere on the board
unnamed: J10.2, XR_PUL1.2 (C)
unnamed: J10.4, XR_DIR1.2 (C)
unnamed: R17.2, XR_PUL1.3 (B)
unnamed: R18.2, XR_DIR1.3 (B)
XR_DIR: R18.1; also elsewhere on the board
XR_STEP: R17.1; also elsewhere on the board

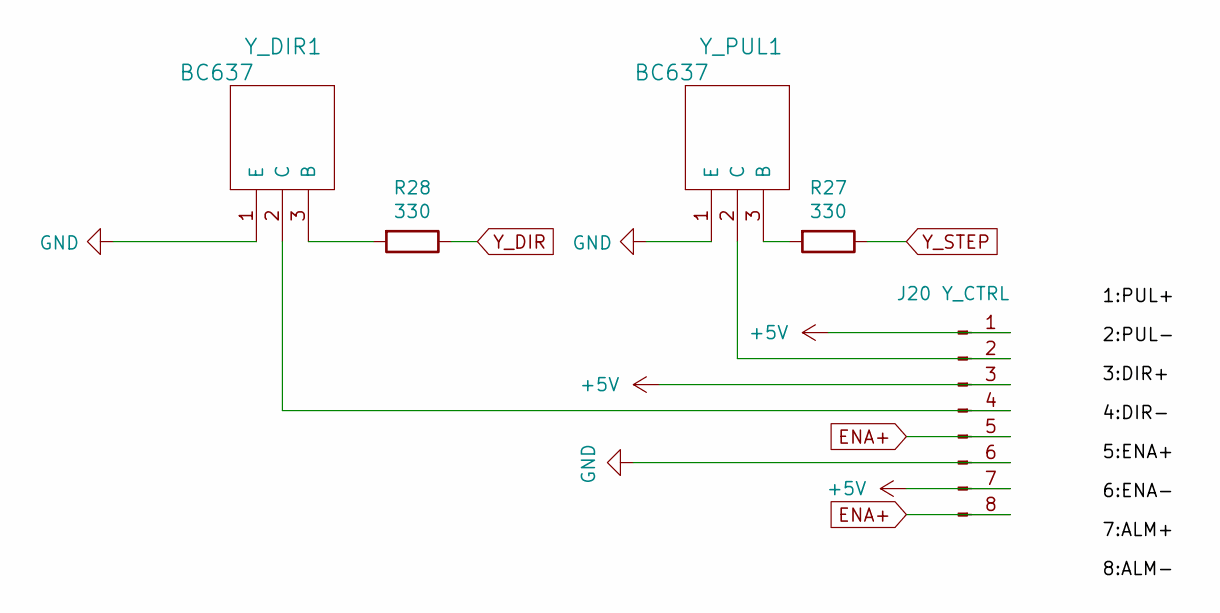
[picture p28: schematic Yctrl.kicad_sch]

Parts:
J20: Y_CTRL; JST_EH_B8B-EH-A_1x08_P2.50mm_Vertical
R27, R28: 330; R_1210_3225Metric_Pad1.30x2.65mm_HandSolder
Y_DIR1: BC637; TO-92_HandSolder
Y_PUL1: BC637; TO-92_HandSolder

Connections:
+5V: J20.1, J20.3, J20.7; also elsewhere on the board
ENA+: J20.5, J20.8; also elsewhere on the board
GND: J20.6, Y_DIR1.1 (E), Y_PUL1.1 (E); also elsewhere on the board
unnamed: R27.2, Y_PUL1.3 (B)
unnamed: R28.2, Y_DIR1.3 (B)
unnamed: J20.4, Y_DIR1.2 (C)
unnamed: J20.2, Y_PUL1.2 (C)
Y_DIR: R28.1; also elsewhere on the board
Y_STEP: R27.1; also elsewhere on the board

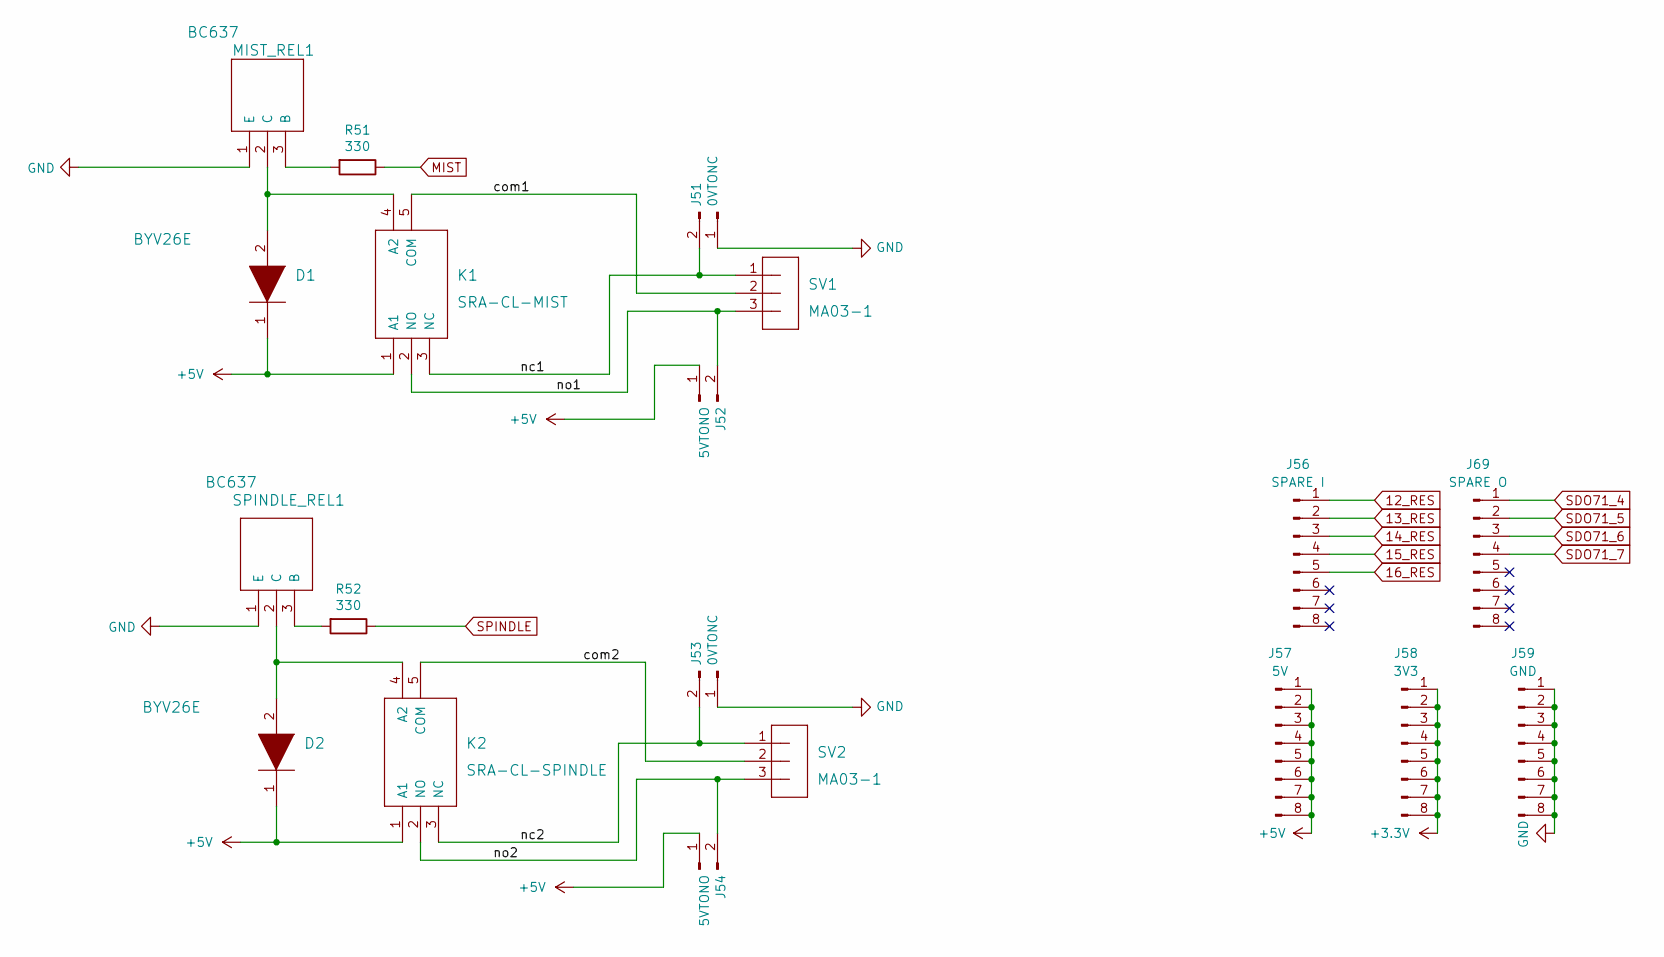
[picture p29: schematic rest.kicad_sch]

Parts:
D1, D2: BYV26E; D_A-405_P7.62mm_Horizontal
J51, J53: 0VTONC; PinHeader_1x02_P2.54mm_Vertical
J52, J54: 5VTONO; PinHeader_1x02_P2.54mm_Vertical
J56: SPARE I; PinHeader_1x08_P2.54mm_Vertical
J57: 5V; PinHeader_1x08_P2.54mm_Vertical
J58: 3V3; PinHeader_1x08_P2.54mm_Vertical
J59: GND; PinHeader_1x08_P2.54mm_Vertical
J69: SPARE O; PinHeader_1x08_P2.54mm_Vertical
K1: SRA-CL-MIST; SRA12VDCCL
K2: SRA-CL-SPINDLE; SRA12VDCCL
MIST_REL1: BC637; TO-92_HandSolder
R51, R52: 330; R_1210_3225Metric_Pad1.30x2.65mm_HandSolder
SPINDLE_REL1: BC637; TO-92_HandSolder
SV1, SV2: MA03-1; PhoenixContact_MCV_1,5_3-G-5.08_1x03_P5.08mm_Vertical

Connections:
12_RES: J56.1; also elsewhere on the board
13_RES: J56.2; also elsewhere on the board
14_RES: J56.3; also elsewhere on the board
15_RES: J56.4; also elsewhere on the board
16_RES: J56.5; also elsewhere on the board
+3.3V: J58.1, J58.2, J58.3, J58.4, J58.5, J58.6, J58.7, J58.8; also elsewhere on the board
+5V: D1.1 (K), D2.1 (K), J52.1, J54.1, J57.1, J57.2, J57.3, J57.4, J57.5, J57.6, J57.7, J57.8, K1.1 (A1), K2.1 (A1); also elsewhere on the board
/rest/com1: K1.5 (COM), SV1.2
/rest/com2: K2.5 (COM), SV2.2
/rest/nc1: J51.2, K1.3 (NC), SV1.1
/rest/nc2: J53.2, K2.3 (NC), SV2.1
/rest/no1: J52.2, K1.2 (NO), SV1.3
/rest/no2: J54.2, K2.2 (NO), SV2.3
GND: J51.1, J53.1, J59.1, J59.2, J59.3, J59.4, J59.5, J59.6, J59.7, J59.8, MIST_REL1.1 (E), SPINDLE_REL1.1 (E); also elsewhere on the board
MIST: R51.1; also elsewhere on the board
unnamed: D1.2 (A), K1.4 (A2), MIST_REL1.2 (C)
unnamed: D2.2 (A), K2.4 (A2), SPINDLE_REL1.2 (C)
unnamed: MIST_REL1.3 (B), R51.2
unnamed: R52.2, SPINDLE_REL1.3 (B)
SDO71_4: J69.1; also elsewhere on the board
SDO71_5: J69.2; also elsewhere on the board
SDO71_6: J69.3; also elsewhere on the board
SDO71_7: J69.4; also elsewhere on the board
SPINDLE: R52.1; also elsewhere on the board

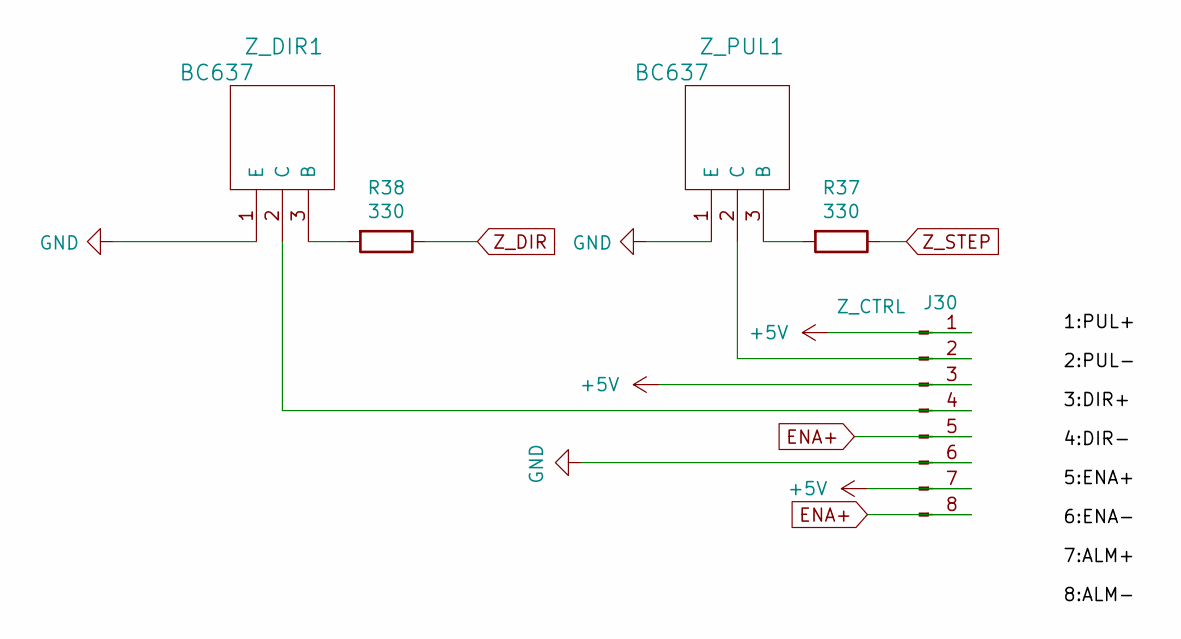
[picture p30: schematic Zctrl.kicad_sch]

Parts:
J30: Z_CTRL; JST_EH_B8B-EH-A_1x08_P2.50mm_Vertical
R37, R38: 330; R_1210_3225Metric_Pad1.30x2.65mm_HandSolder
Z_DIR1: BC637; TO-92_HandSolder
Z_PUL1: BC637; TO-92_HandSolder

Connections:
+5V: J30.1, J30.3, J30.7; also elsewhere on the board
ENA+: J30.5, J30.8; also elsewhere on the board
GND: J30.6, Z_DIR1.1 (E), Z_PUL1.1 (E); also elsewhere on the board
unnamed: R37.2, Z_PUL1.3 (B)
unnamed: R38.2, Z_DIR1.3 (B)
unnamed: J30.4, Z_DIR1.2 (C)
unnamed: J30.2, Z_PUL1.2 (C)
Z_DIR: R38.1; also elsewhere on the board
Z_STEP: R37.1; also elsewhere on the board

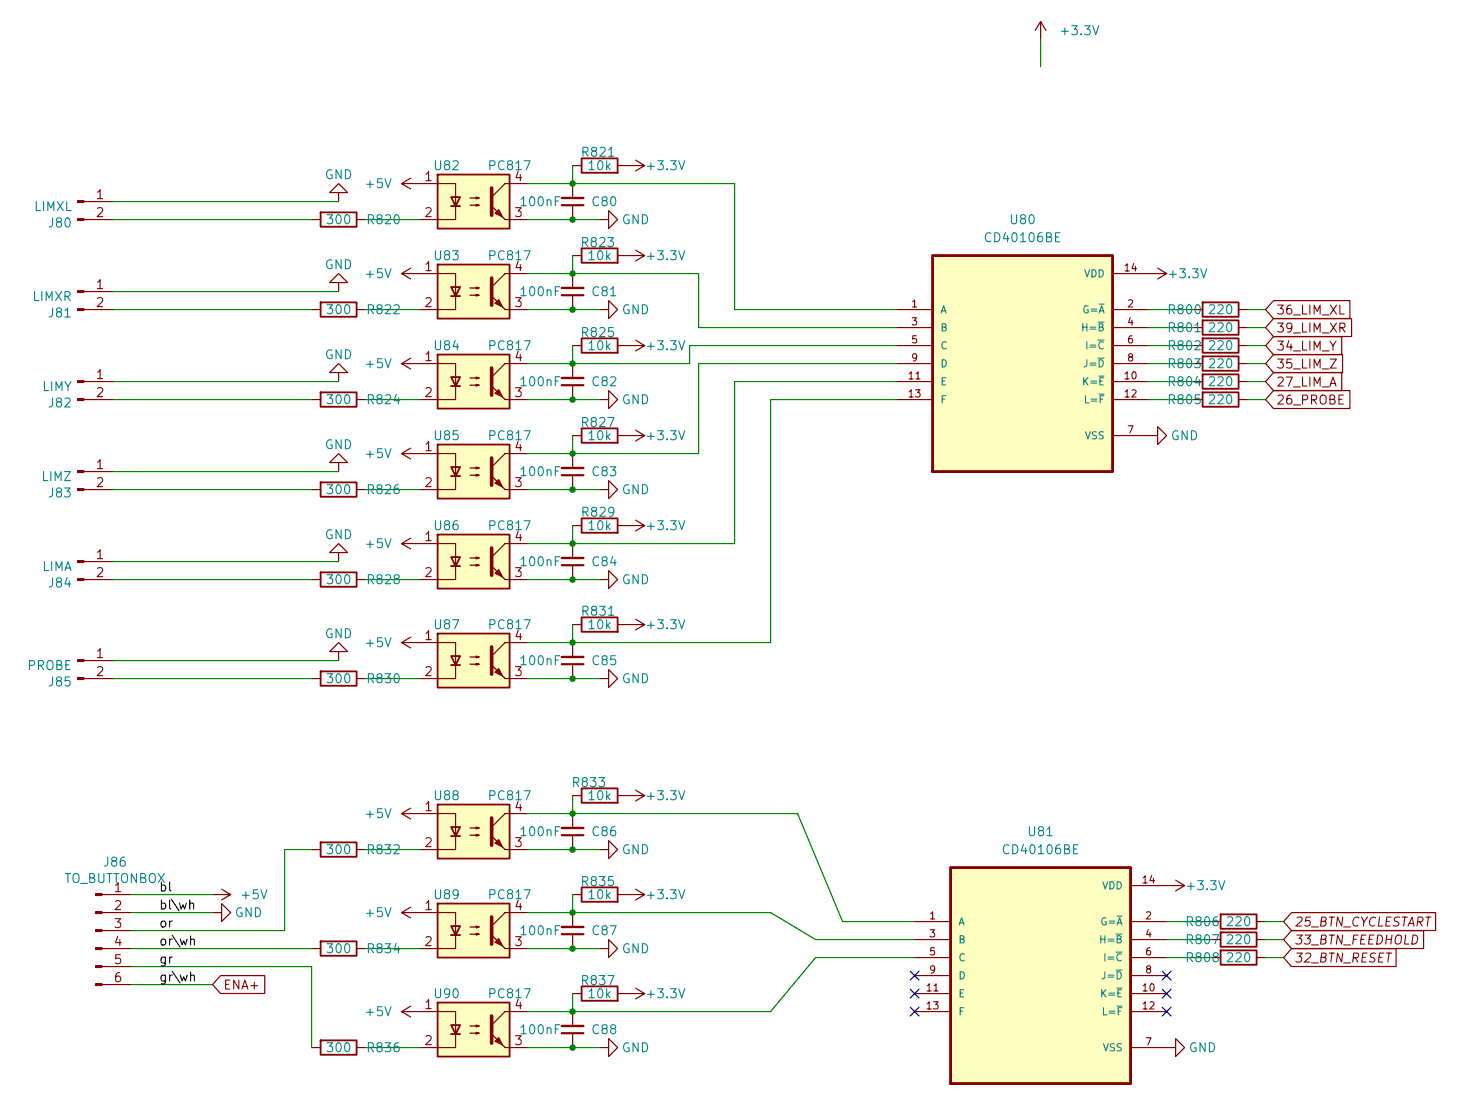
[picture p31: schematic schmitt trigger chips.kicad_sch]

Parts:
C80, C81, C82, C83, C84, C85, C86, C87, C88: 100nF; C_Disc_D5.0mm_W2.5mm_P2.50mm
J80: LIMXL; JST_EH_B2B-EH-A_1x02_P2.50mm_Vertical
J81: LIMXR; JST_EH_B2B-EH-A_1x02_P2.50mm_Vertical
J82: LIMY; JST_EH_B2B-EH-A_1x02_P2.50mm_Vertical
J83: LIMZ; JST_EH_B2B-EH-A_1x02_P2.50mm_Vertical
J84: LIMA; JST_EH_B2B-EH-A_1x02_P2.50mm_Vertical
J85: PROBE; JST_EH_B2B-EH-A_1x02_P2.50mm_Vertical
J86: TO_BUTTONBOX; JST_EH_B6B-EH-A_1x06_P2.50mm_Vertical
R800, R801, R802, R803, R804, R805, R806, R807, R808: 220; R_1210_3225Metric_Pad1.30x2.65mm_HandSolder
R820, R822, R824, R826, R828, R830, R832, R834, R836: 300; R_1210_3225Metric_Pad1.30x2.65mm_HandSolder
R821, R823, R825, R827, R829, R831, R833, R835, R837: 10k; R_1210_3225Metric_Pad1.30x2.65mm_HandSolder
U80, U81: CD40106BE; DIP794W45P254L1969H508Q14
U82, U83, U84, U85, U86, U87, U88, U89, U90: PC817; DIP-4_W7.62mm

Connections:
25_BTN_CYCLESTART: R806.1; also elsewhere on the board
26_PROBE: R805.1; also elsewhere on the board
27_LIM_A: R804.1; also elsewhere on the board
32_BTN_RESET: R808.1; also elsewhere on the board
33_BTN_FEEDHOLD: R807.1; also elsewhere on the board
34_LIM_Y: R802.1; also elsewhere on the board
35_LIM_Z: R803.1; also elsewhere on the board
36_LIM_XL: R800.1; also elsewhere on the board
39_LIM_XR: R801.1; also elsewhere on the board
+3.3V: R821.2, R823.2, R825.2, R827.2, R829.2, R831.2, R833.2, R835.2, R837.2, U80.14 (VDD), U81.14 (VDD); also elsewhere on the board
+5V: J86.1, U82.1, U83.1, U84.1, U85.1, U86.1, U87.1, U88.1, U89.1, U90.1; also elsewhere on the board
/schmitt trigger chips/gr: J86.5, R836.2
/schmitt trigger chips/or: J86.3, R832.2
/schmitt trigger chips/or\wh: J86.4, R834.2
ENA+: J86.6; also elsewhere on the board
GND: C80.1, C81.1, C82.1, C83.1, C84.1, C85.1, C86.1, C87.1, C88.1, J80.1, J81.1, J82.1, J83.1, J84.1, J85.1, J86.2, U80.7 (VSS), U81.7 (VSS), U82.3, U83.3, U84.3, U85.3, U86.3, U87.3, U88.3, U89.3, U90.3; also elsewhere on the board
unnamed: C80.2, R821.1, U80.1 (A), U82.4
unnamed: C81.2, R823.1, U80.3 (B), U83.4
unnamed: C82.2, R825.1, U80.5 (C), U84.4
unnamed: C83.2, R827.1, U80.9 (D), U85.4
unnamed: C84.2, R829.1, U80.11 (E), U86.4
unnamed: C85.2, R831.1, U80.13 (F), U87.4
unnamed: C86.2, R833.1, U81.1 (A), U88.4
unnamed: C87.2, R835.1, U81.3 (B), U89.4
unnamed: C88.2, R837.1, U81.5 (C), U90.4
unnamed: J80.2, R820.2
unnamed: J81.2, R822.2
unnamed: J82.2, R824.2
unnamed: J83.2, R826.2
unnamed: J84.2, R828.2
unnamed: J85.2, R830.2
unnamed: R800.2, U80.2 (G=~A)
unnamed: R801.2, U80.4 (H=~B)
unnamed: R802.2, U80.6 (I=~C)
unnamed: R803.2, U80.8 (J=~D)
unnamed: R804.2, U80.10 (K=~E)
unnamed: R805.2, U80.12 (L=~F)
unnamed: R806.2, U81.2 (G=~A)
unnamed: R807.2, U81.4 (H=~B)
unnamed: R808.2, U81.6 (I=~C)
unnamed: R820.1, U82.2
unnamed: R822.1, U83.2
unnamed: R824.1, U84.2
unnamed: R826.1, U85.2
unnamed: R828.1, U86.2
unnamed: R830.1, U87.2
unnamed: R832.1, U88.2
unnamed: R834.1, U89.2
unnamed: R836.1, U90.2

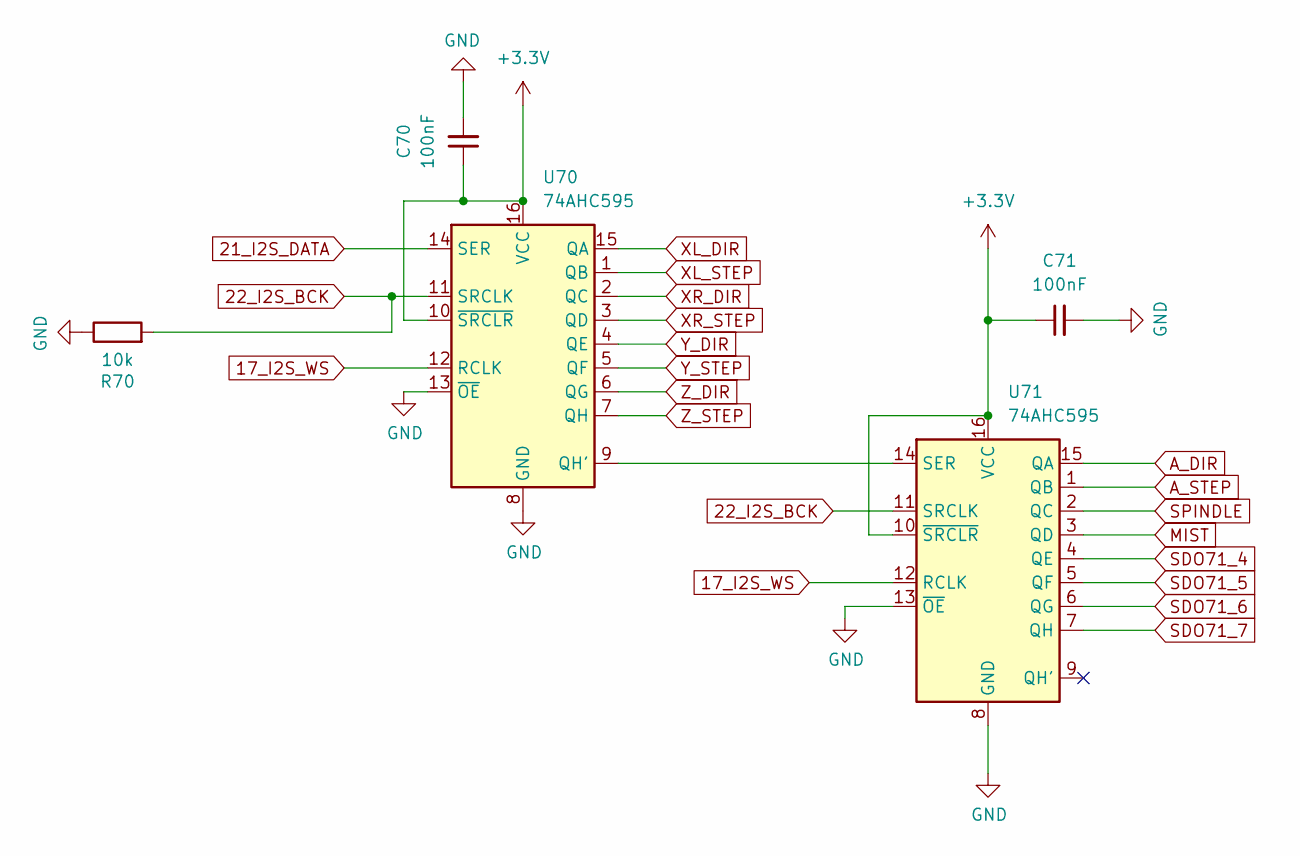
[picture p32: schematic sdoChips.kicad_sch]

Parts:
C70, C71: 100nF; C_Disc_D5.0mm_W2.5mm_P2.50mm
R70: 10k; R_1210_3225Metric_Pad1.30x2.65mm_HandSolder
U70, U71: 74AHC595; DIP-16_W7.62mm_Socket

Connections:
17_I2S_WS: U70.12 (RCLK), U71.12 (RCLK); also elsewhere on the board
21_I2S_DATA: U70.14 (SER); also elsewhere on the board
22_I2S_BCK: R70.2, U70.11 (SRCLK), U71.11 (SRCLK); also elsewhere on the board
+3.3V: C70.1, C71.1, U70.10 (~SRCLR), U70.16 (VCC), U71.10 (~SRCLR), U71.16 (VCC); also elsewhere on the board
A_DIR: U71.15 (QA); also elsewhere on the board
A_STEP: U71.1 (QB); also elsewhere on the board
GND: C70.2, C71.2, R70.1, U70.8 (GND), U70.13 (~OE), U71.8 (GND), U71.13 (~OE); also elsewhere on the board
MIST: U71.3 (QD); also elsewhere on the board
unnamed: U70.9 (QH'), U71.14 (SER)
SDO71_4: U71.4 (QE); also elsewhere on the board
SDO71_5: U71.5 (QF); also elsewhere on the board
SDO71_6: U71.6 (QG); also elsewhere on the board
SDO71_7: U71.7 (QH); also elsewhere on the board
SPINDLE: U71.2 (QC); also elsewhere on the board
XL_DIR: U70.15 (QA); also elsewhere on the board
XL_STEP: U70.1 (QB); also elsewhere on the board
XR_DIR: U70.2 (QC); also elsewhere on the board
XR_STEP: U70.3 (QD); also elsewhere on the board
Y_DIR: U70.4 (QE); also elsewhere on the board
Y_STEP: U70.5 (QF); also elsewhere on the board
Z_DIR: U70.6 (QG); also elsewhere on the board
Z_STEP: U70.7 (QH); also elsewhere on the board

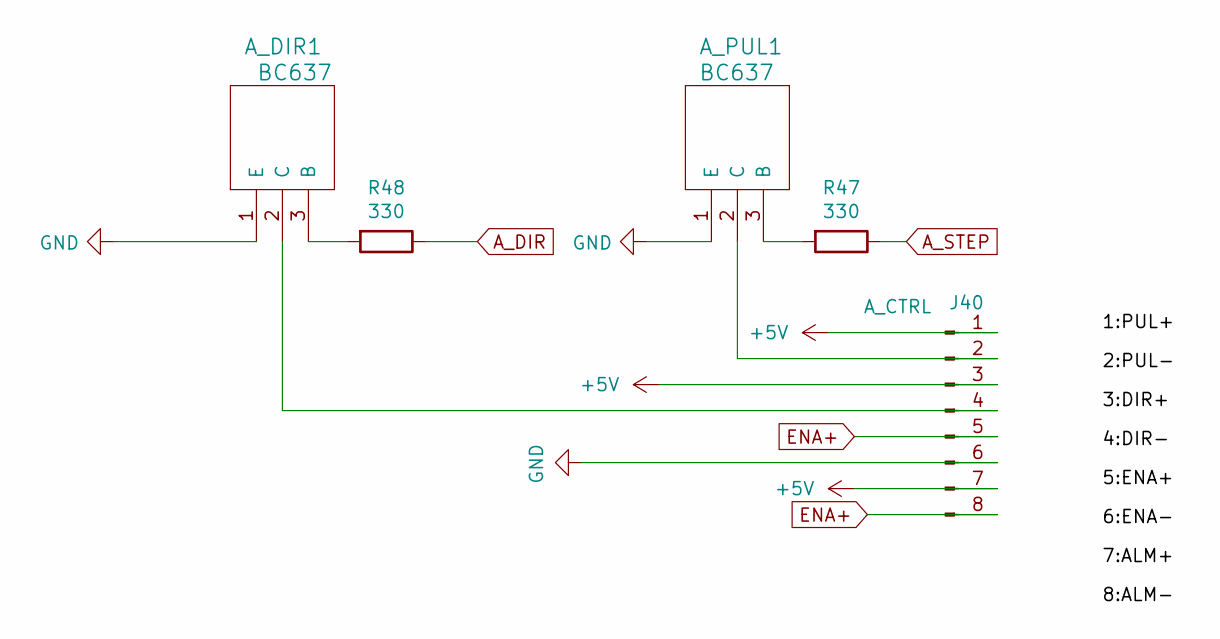
[picture p33: schematic Actrl.kicad_sch]

Parts:
A_DIR1: BC637; TO-92_HandSolder
A_PUL1: BC637; TO-92_HandSolder
J40: A_CTRL; JST_EH_B8B-EH-A_1x08_P2.50mm_Vertical
R47, R48: 330; R_1210_3225Metric_Pad1.30x2.65mm_HandSolder

Connections:
+5V: J40.1, J40.3, J40.7; also elsewhere on the board
A_DIR: R48.1; also elsewhere on the board
A_STEP: R47.1; also elsewhere on the board
ENA+: J40.5, J40.8; also elsewhere on the board
GND: A_DIR1.1 (E), A_PUL1.1 (E), J40.6; also elsewhere on the board
unnamed: A_DIR1.2 (C), J40.4
unnamed: A_DIR1.3 (B), R48.2
unnamed: A_PUL1.2 (C), J40.2
unnamed: A_PUL1.3 (B), R47.2

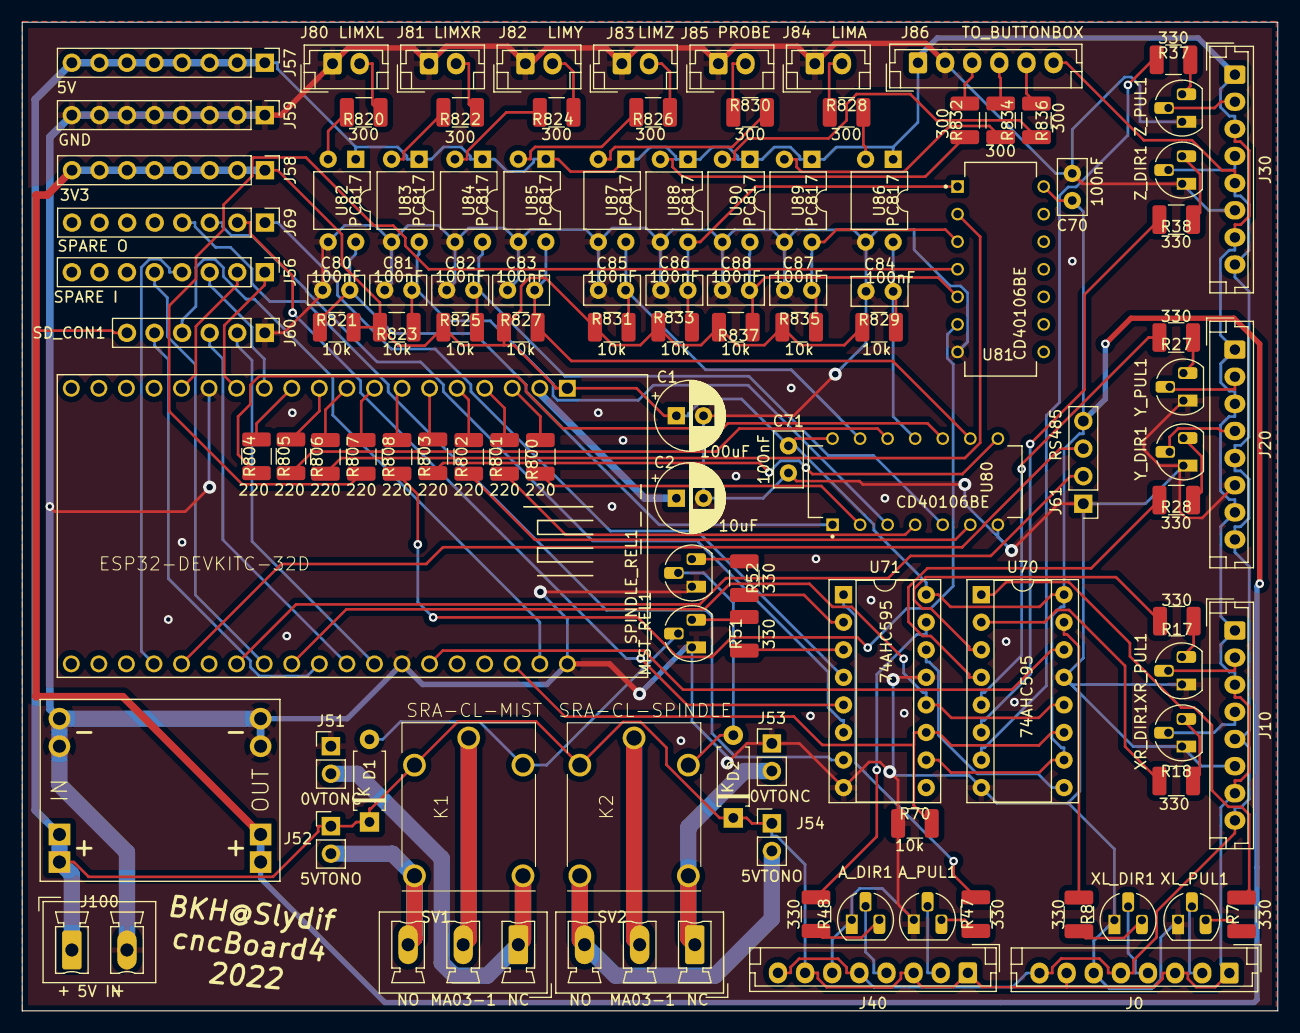
[picture p34: board cncBord4sdo.kicad_pcb from above]

Board: 2 copper layers, 115.7 x 91.1 mm, 110 parts (0 on the bottom side), 111 nets.
