slydif/cncBoard-for-fluidnc/cncBord4sdo/projectData/6-Pack_CNC_Controller-main/CNC_IO_Modules/High_Current_Analog/source/High_Current_Analog.kicad_pcb

## KiCad design cncBord4sdo/projectData/6-Pack_CNC_Controller-main/CNC_IO_Modules/High_Current_Analog/source/High_Current_Analog.kicad_pcb (2023-04-05)

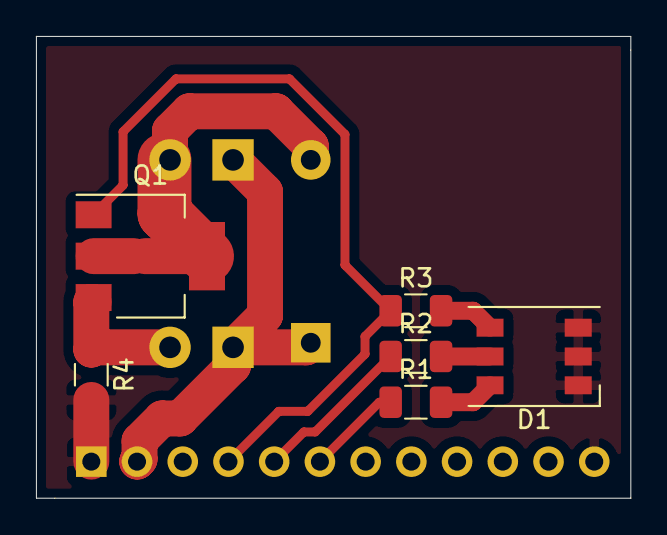
[picture p35: board High_Current_Analog.kicad_pcb from above]

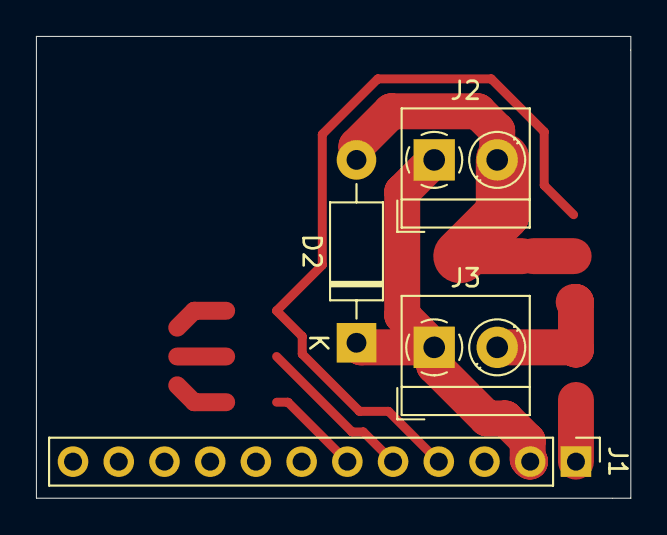
[picture p36: board High_Current_Analog.kicad_pcb from below]

Board: 2 copper layers, 33.0 x 25.7 mm, 10 parts (4 on the bottom side), 10 nets.

Parts:
D1: LED_RGB; LED_WS2812_PLCC6_5.0x5.0mm_P1.6mm
D2: 1N4003; D_DO-41_SOD81_P10.16mm_Horizontal
J1: Conn_01x12_Male; PinHeader_1x12_P2.54mm_Vertical
J2, J3: Screw_Terminal_01x02; TerminalBlock_MetzConnect_Type059_RT06302HBWC_1x02_P3.50mm_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
Q1: Q_NMOS_GDSD; SOT-223
R1, R2, R3, R4: R; R_1206_3216Metric

Connections:
GND: D1.1, D1.2, D1.3, J1.1, J1.12, R4.2
GNDPWR: J3.2, Q1.3, R4.1
IN1: J1.4, Q1.1, R3.1
IN2: J1.5, R2.1
IN3: J1.6, R1.1
unnamed: D1.4, R3.2
unnamed: D1.5, R2.2
unnamed: D1.6, R1.2
OUT1: D2.2, J2.2, Q1.2, Q1.4
VCC: D2.1, J1.2, J2.1, J3.1
