slydif/cncBoard-for-fluidnc/cncBord4sdo/projectData/6-Pack_CNC_Controller-main/FluidNC_configs/6P_extn_XYZAB_relay.yaml

board: 6 Pack
name: 6 Pack External XYZAB
meta: 2022-03-227 B. Dring for Nicholas Zivkovic 319639
stepping:
  engine: I2S_STREAM
  idle_ms: 250
  pulse_us: 4
  dir_delay_us: 1
  disable_delay_us: 0

axes:
  shared_stepper_disable_pin: NO_PIN
  x:
    steps_per_mm: 100.000
    max_rate_mm_per_min: 5000.000
    acceleration_mm_per_sec2: 50.000
    max_travel_mm: 300.000
    soft_limits: false
    homing:
      cycle: 1
      positive_direction: true
      mpos_mm: 0.000
      feed_mm_per_min: 100.000
      seek_mm_per_min: 200.000
      settle_ms: 500
      seek_scaler: 1.100
      feed_scaler: 1.100

    motor0:
      limit_neg_pin: gpio.33:low
      limit_pos_pin: gpio.32:low
      limit_all_pin: NO_PIN
      hard_limits: true
      pulloff_mm:1.000
      standard_stepper:
        step_pin: I2SO.2
        direction_pin: I2SO.1
        disable_pin: I2SO.0

  y:
    steps_per_mm: 100.000
    max_rate_mm_per_min: 5000.000
    acceleration_mm_per_sec2: 50.000
    max_travel_mm: 300.000
    soft_limits: false
    homing:
      cycle: 2
      positive_direction: true
      mpos_mm: 0.000
      feed_mm_per_min: 100.000
      seek_mm_per_min: 200.000
      settle_ms: 500
      seek_scaler: 1.100
      feed_scaler: 1.100

    motor0:
      limit_neg_pin: gpio.35:low
      limit_pos_pin: gpio.34:low
      limit_all_pin: NO_PIN
      hard_limits: true
      pulloff_mm:1.000
      standard_stepper:
        step_pin: I2SO.5
        direction_pin: I2SO.4
        disable_pin: I2SO.7
        
  z:
    steps_per_mm: 100.000
    max_rate_mm_per_min: 5000.000
    acceleration_mm_per_sec2: 200.000
    max_travel_mm: 1000.000
    soft_limits: false
    homing:
      cycle: 0
      positive_direction: true
      mpos_mm: 0.000
      feed_mm_per_min: 100.000
      seek_mm_per_min: 200.000
      settle_ms: 500
      seek_scaler: 1.100
      feed_scaler: 1.100
        
    motor0:
      limit_neg_pin: gpio.39:low
      limit_pos_pin: gpio.36:low
      limit_all_pin: NO_PIN
      hard_limits: true
      pulloff_mm:1.000
      null_motor:
        
  a:
    steps_per_mm: 100.000
    max_rate_mm_per_min: 5000.000
    acceleration_mm_per_sec2: 50.000
    max_travel_mm: 300.000
    soft_limits: false
    homing:
      cycle: 3
      positive_direction: true
      mpos_mm: 0.000
      feed_mm_per_min: 100.000
      seek_mm_per_min: 200.000
      settle_ms: 500
      seek_scaler: 1.100
      feed_scaler: 1.100
        
    motor0:
      limit_neg_pin: NO_PIN
      limit_pos_pin: NO_PIN
      limit_all_pin: NO_PIN
      hard_limits: false
      pulloff_mm:1.000
      standard_stepper:
        step_pin: I2SO.10
        direction_pin: I2SO.9
        disable_pin: I2SO.8
        
  b:
    steps_per_mm: 100.000
    max_rate_mm_per_min: 5000.000
    acceleration_mm_per_sec2: 50.000
    max_travel_mm: 300.000
    soft_limits: false
    homing:
      cycle: 3
      positive_direction: true
      mpos_mm: 0.000
      feed_mm_per_min: 100.000
      seek_mm_per_min: 200.000
      settle_ms: 500
      seek_scaler: 1.100
      feed_scaler: 1.100
        
    motor0:
      limit_neg_pin: NO_PIN
      limit_pos_pin: NO_PIN
      limit_all_pin: NO_PIN
      hard_limits: false
      pulloff_mm:1.000
      standard_stepper:
        step_pin: I2SO.13
        direction_pin: I2SO.12
        disable_pin: I2SO.15

i2so:
  bck_pin: gpio.22
  data_pin: gpio.21
  ws_pin: gpio.17

spi:
  miso_pin: gpio.19
  mosi_pin: gpio.23
  sck_pin: gpio.18

sdcard:
  card_detect_pin: NO_PIN
  cs_pin: gpio.5
  
  
laser:
  
